aherkelman/Bachelors-Thesis-/Images/IMP/testArea.jpg

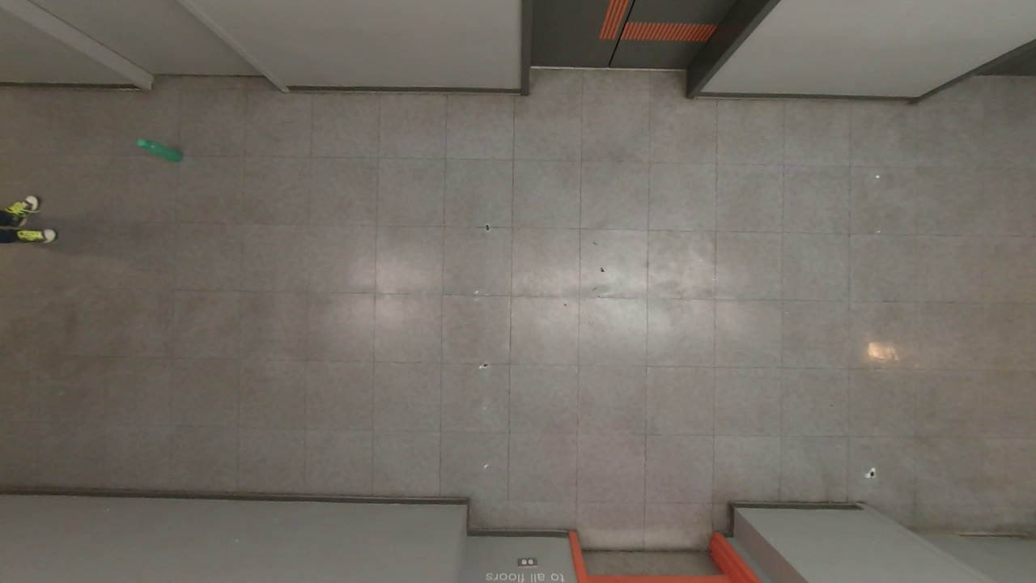
Images/IMP/testArea.jpg
