aherkelman/Bachelors-Thesis-/Images/results/1.JPG

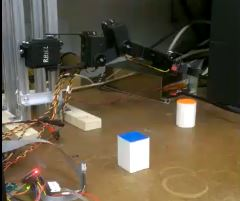
Images/results/1.JPG
