aherkelman/Bachelors-Thesis-/README.md

Bachelors-Thesis-  This project contains my bachelors thesis from 2015. See the .pdf for the printed out version.

Everything in this folder is part of the laTex generation for this thesis.
