aherkelman/Bachelors-Thesis-/Chapters/appendix.tex

\appendix

\chapter{CameraCode}\label{chap:sim_code}

\section{Object Tracking Method 1}
\lstinputlisting[basicstyle=\scriptsize,breaklines=true,language=C++]{./Code/camera1.cpp}
\section{Object Tracking Method 2}
\lstinputlisting[basicstyle=\scriptsize,breaklines=true,language=C++]{./Code/camera2.cpp}

\chapter{Path Planning and Communication}\label{chap:nao_code}

\section{Main Code}
\lstinputlisting[basicstyle=\scriptsize,breaklines=true,language=python]{./code/armTrackingMaster.py}
\section{Computer Communication}
\lstinputlisting[basicstyle=\scriptsize,breaklines=true,language=python]{./code/comms.py}
\section{Micro Controller Communication}
\lstinputlisting[basicstyle=\scriptsize,breaklines=true,language=python]{./code/communication.py}
\section{Path Planner}
\lstinputlisting[basicstyle=\scriptsize,breaklines=true,language=python]{./code/PathPlanner.py}
\section{Kinematics}
\lstinputlisting[basicstyle=\scriptsize,breaklines=true,language=python]{./code/arm.py}

\chapter{Arm Code}
\section{Main Code}
\lstinputlisting[basicstyle=\scriptsize,breaklines=true,language=C]{./code/arm_main.c}
\section{Arm Functions}
\lstinputlisting[basicstyle=\scriptsize,breaklines=true,language=C]{./code/arm.c}
