aherkelman/Bachelors-Thesis-/mainfile.pdf

# Path Planning and Object Detection for a

# Robotic Manipulator

Alaina Herkelman

May 12, 2015

Abstract

Path planning is a crucial part of controlling a robotic manipulator. To move

in an unknown environment sensors must be utilized for generating workspace

information. In this report an A start based path planning algorithm was imple-

mented for a four degree of freedom manipulator. A three dimensional camera

was used to locate the goal and obstacles within the manipulators workspace.

The results of real world implementation, modeling and the theory behind them

are discussed.

# Contents

1 Introduction | 1
2 Literature Survey | 3
3 Kinematics | 8
4 Hardware | 13
5 Image Processing | 17

i

6 Finding Ground Truth for a Mobile Platform | 26
7 Path Planning | 30
8 Modeling | 32
9 Results | 35
10 Conclusion | 39
A CameraCode | 41
B Path Planning and Communication | 49
C Arm Code | 66

ii

# List of Figures

3.1 The Mobile Manipulator | | 8
3.2 The Mobile Manipulator with Coordinate Frames | | 9
3.3 Projections for solving the inverse kinematics geometrically. . . . | 11
3.4 Workspace of the manipulator | | | 12
4.1 The manipulator | | 13
4.2 System diagram of the manipulator | | 14
4.3 Diagram of manipulator control system | | 14
4.4 Connection Circuit for Manipulator | | 15
4.5 Gripper holding cylindrical object | | 16
5.1 Arm with Camera Mounted Above | | 20
5.2 Locating a blue object in camera image. | | | 23
5.3 Shapes located in image, labeled by program | | 25
6.1 Solidworks model of GoPro mount | | 28
6.2 View of test area from GoPro | | 29
6.3 Found path of mobile platform drawn on camera image | | 29
8.1 Arm graphed onto 3D image in Matlab | | 32
8.2 Path planning simulation in matlab | | 33
8.3 Path planning model in V-REP | | 34
9.1 Manipulator moving through a planned path. | | | 38

iii

# List of Tables

3.1 D-H table | | 9
4.1 List of major components on the robotic manipulator system. . . | 15

iv

# Chapter 1

# Introduction

Robotics is becoming a more popular and useful field in the world today. Sensors

have become more accurate and practical for mapping environments allowing

robots to be used in more situations. Robotic manipulator’s are used for situa-

tions where repetitive or dangerous tasks can be replaced with robotic . This is

most commonly found in areas such as manufacturing. Combining manipulators

with machine vision allows manipulators to adapt to different environments by

visualizing the workspace.

For this project a four degree of freedom robotic manipulator was used to

grab objects within its workspace while avoiding other found obstacles. A three

dimensional camera was used to gather data about the manipulator’s workspace.

Computer vision algorithms were developed to locate known objects within the

camera’s field of view. A path planning algorithm was then set up to calculate

a path from the current arm position to a goal object and pick it up.

The algorithm used for path planning was a graph search method with an

addition of a potential fields component to help the arm avoid obstacles while

still moving towards the goal. The vision algorithms located goal objects and

obstacles by using color and basic shape detection.

The report follows the following setup: Chapter 2 discusses different methods

of path planning and object detection in images, Chapter 3 shows the results

of the kinematic models of the manipulator, Chapter 4 goes over the hardware

setup for this project, Chapter 5 states the results of developing image processing

algorithms, Chapter 6 overviews another application for computer vision in

robotics, Chapter 7 goes over the development of the path planning algorithm,

Chapters 8 and 9 discuss the results of the path planing in simulation and real

world implementation, Chapter 10 is the conclusion of the project.

# Chapter 2

# Literature Survey

Path planning is a way to generate a path for a robot to meet certain input

conditions. It is often desired to move the robot from one place to another while

going around any objects that may be in the way. The steps to do this can be

broken into two major components: finding information about the workspace

and using an algorithm to develop the path.

Path planning can be done in both static and dynamic environments. A

static environment is one that does not change. Once the workspace has been

visualized it is assumed none of the objects move. In a dynamic environment

the surroundings of the robot do change. This means that the workspace infor-

mation will change in position as the robot moves. It then becomes necessary

to both visualize and plan a path simultaneously, requiring better speed and

flexibility for both the path planner and vision methods.

## 2.1 Visualizing a Workspace

Generating data about a workspace requires some type of sensor, or sensors,

which can provide data about the robot’s surroundings. The most common

methods for this involve vision sensors and distance sensors. The overall goal is

to create some knowledge of the 3 dimensional workspace of the robot. Camera’s

are useful in locating obstacles but need some method to convert from pixels to

real world coordinates. To locate a goal in an environment using computer vision

requires some method of object recognition. There are a number of different

methods and programming libraries to help with this problem. A few common methods are described below.

### 2.1.1 Color Based

One method of finding on object in an image is based on color. The range

of pixel values for a certain color can be saved to an algorithm that searched

through an image to find pixel values within that color range. To create accurate

data from this requires some amount of filtering and correction on the image to

reduce the impact noise. The major downfall of this method is that the color

must be known to find the object and if any objects, besides the desired, are

in the same color range the results of the detection will not return the right

data. This method is therefore most useful in controlled environments where

the colors of objects in the image can be selected.

### 2.1.2 Geometery Based

An alternative to finding by color is finding by shape. The basic principle of

this is to search through the edges of an image for geometric shapes. This can

be done to find any primitive shapes in an image. A more complex shape can

be broken into a combination of geometric primitives to be located using this

method. To find a primitive shape in an image a method for edge detecting

must be used. From found edges in the image these can be searched to find the

contours matching the desired simple shape.

### 2.1.3 Feature Based

This method finds a known object in an image by comparing known ’features’

of the object to an image. An algorithm is run to find distinctive parts of an

object from a picture of it. These features are commonly lines, points, shapes

but can be anything else generated. An array of these features can be saved

and compared to features in another image. If enough of the object’s features

are found then the object is said to be found in the image. This method is

a bit more complicated but works best for finding complex objects in a more

cluttered environment.

## 2.2 Path Planning

There are many different solutions that have been developed to solve the path

planning problem. Two of the most popular are potential fields and graph

search. These methods can be broken down into more specific algorithms but

all share similar aspects.

### 2.2.1 Potential Fields

The potential fields method uses an equation to calculate the next step of the

path by repelling the solution away from obstacles while attracting it to the

goal. The equation acts as a cost function of which the global minimum is the

goal. The cost will increase the closer the obstacles and the cost will decrease

the closer to the goal. The cost functions is comprised of two parts; an attractive

field and a repulsive field.

The shape of equation that directly solves the attractive field is a conical,

which is a concave shape with the center at the goal. The problem with this

equation is that it is not continuous which causes most optimization methods

to be impossible. To fix this a quadratic equation, which increases the farther

from the goal, is added to the conic equation. The resulting equation for the

attractive field is shown in equation 2.1.

Uattract(q) =

1/2 ζdist(q, q0)

2
if dist(q, q0) ≤ d∗

d ∗ ζdist(q, q0) −

1/2 ζd²
if dist(q, q0) > d∗

(2.1)

Where ζ is a scaling factor, dist(x,y) is the distance between x and y, q is

current position, q0 is goal position, and d* is the distance between the conical

and parabolic well.

The repulsive field is set to increase quadratically based on how close the

robot is to each obstacle. For a manipulator the end effector cannot be the only

chosen point looked at in terms of collision. While the goal would only need to

look at the end effector for the attractive field, since that is the only part of the

arm desired to be at that goal. For the obstacles no point on the link is desired

to touch the obstacle. This means the whole arm, not just the end effector must

be checked for collision with the obstacle. A way to do this is by calculating

which point on the manipulator is closest to the obstacle and use that distance

to calculate the repulsive field. The result of this is shown in equation 2.2.

Urepel(q) =

1/2 ζ(

1
P (q) −

1
P0

)

2
ifP(q) ≤ P0

0 ifP(q) > P0

(2.2)

Where ζ is a tuning parameter, Pq is the distance from the closest point on the

robot to the obstacle, and P0 is the distance at which the obstacle should no

longer effect the cost.

To calculate the overall cost function the attractive and repulsive fields are

added resulting in the overall cost function. This becomes an optimization

problem and can be solved using optimization methods. The most widely used

of these for the path planning problem is the gradient descent algorithm.

The biggest problem with using potential fields is the local minimum prob-

lem. As gradient decent, or another algorithm for solving the path based on a

potential fields problem, travels through it can get stuck in a local minimum,

where no points around it are cheaper than its current yet it is not at the goal.

There are a number of methods to fix this problem, such as moving away in a

randomized direction and then continuing with the algorithm.

### 2.2.2 Graph Search

The graph search method of path planning works by finding a minimal path

between a start and end position given a set of nodes. Each of these nodes

represents a different state of the object the path planning is done for. For

example the manipulator in this project a node is a set of angles at a given

orientation of the arm. The connection cost between each of these nodes must

also be known, often calculated by distance. Nodes can either be calculated

as the search algorithm is running or generated before searching. The latter

becomes impractical for problems with a high number states and typically nodes

are calculated while searching. There are many different algorithms based on

this method some of which are described below.

## 2.3 Dijkstra’s Algorithm

Dijkstra’s algorithm is a search method which is guaranteed to find the optional

path. To do this it starts at the start node then looks at all of the neighbors. It

saves all of the neighbors of the start node and records the cost to get there. It then looks at the least cost of the saved nodes, removes it from the saved set,

and saves all of its neighbors. This is repeated until the goal is selected as the

point with the least cost.. If at any point a node is found to have a cheaper cost

when reached through a different set of neighbors the new lower cost is saved

as the cost to node. When the goal is found the cost to all nodes from the start

to end have their costs known. The optimal path can then be constructed by

moving backwards from the found end node. While this is guaranteed to find

the least cost path between start and end this algorithm also looks at a large

amount of unnecessary nodes as it looks at neighbors in all directions. This

algorithm is accurate but inefficient.

## 2.4 Greedy Algorithm

On the opposite end of the speed versus accuracy spectrum is the Greedy Algo-

rithm. It works by beginning at the start node and looking at the neighboring

nodes. It then moves to the neighbor with the least cost and throws out all

of the others. It keeps doing this until the end node is reached. This method

creates the optimal path in the optimal amount of time given a very direct path

is the optimal solution. As this is often not the case the greedy algorithm is not

a practical search algorithm.

## 2.5 A*

The A* method follows the same steps as Dijkstra’s algorithm where is saves

all of the neighbors of the node it is currently looking at. Unlike in Dijkstra’s

algorithm the cost is calculated a function of both the cost to reach the node

and an estimate of the cost to the distance. This means the cost is more for

nodes going away from the goal and less for the nodes towards the goal. This

significantly reduces the number of nodes that are looked at as when tuned

properly only likely nodes will be looked at. The A* algorithm provides a

balance between accuracy and time as it only looks at nodes it views as potential

candidates for reaching the goal quickly. If tuned correctly A* will return the

optimal path.

# Chapter 3

# Kinematics

The manipulator used was a four degree of freedom (DOF) arm with a gripper

attached as the end effector. All joints were revolute and implemented by servo

motors. A drawing of the arm is shown in Figure 3.1. To properly control the

manipulator the forward and inverse kinematics were derived.

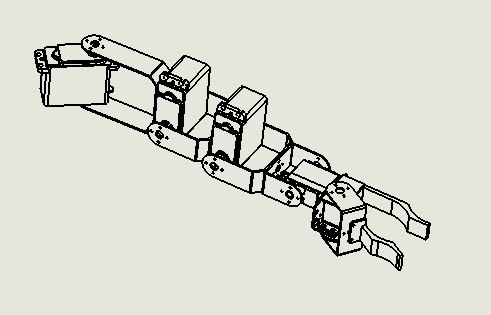
[picture p3: figure]

Figure 3.1: The Mobile Manipulator

## 3.1 Forward Kinematics

Forward kinematics is finding the position and orientation of a manipulator’s

end effector given the position of all of its joints. For this manipulator the end

effector position was calculated in terms of the angles of the first four joints of

the manipulator θ1 - θ4. The gripper was considered only as a length as it has

no effect on the arm’s overall position or orientation. An manipulator simplified

as a drawing of its joints can be seen in Figure 3.2.

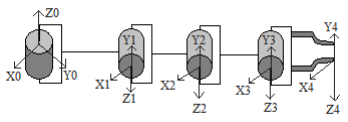
[picture p4: figure]

Figure 3.2: The Mobile Manipulator with Coordinate Frames

Joint | di | αi | ai | θi
1 | 0 | −90o | l1 | θ1∗
2 | 0 | 0 o | l2 | θ2∗
3 | 0 | o 0 | l3 | θ3∗
4 | 0 | 0 o | l4 | θ4∗

Table 3.1: D-H table

The coordinate frames of each of the joints were found using the Devavit-

Hartenberg (D-H) convention. The resulting coordinate frames and DH param-

eters are also drawn in Figure 3.2. The D-H table, which contains each of the

D-H parameters for calculating the transformation matrix of each joint is shown

in Table 1. The matrix for each joint was then calculated using the formula in

equation 3.1 where Ai
is the transformation matrix between the coordinate

frame oixiyizi and oi−1xi−1yi−1zi−1 where o0x0y0z0 is the origin coordinate

frame. The transformation matrix T
0/4, to convert from the coordinate frame of

the end effector to the coordinate frame of the origin is found by multiplying all

of the A matrices together. So T

0
4 = A1 ∗A2 ∗A3 ∗A4. The fourth column of this

matrix represents the the 3-Dimensional (3D) coordinates of the manipulator’s

end effector with respect to the origin coordinate frame. R14 is the x position

R24 is the y position and R34 is the z position where R =

r11 | r12 | r13 | r14
r21 | r22 | r23 | r24
r31 | r32 | r33 | r34
r41 | r42 | r43 | r44

This column then returns the equations for x, y, and z in terms of the angles

θ1 - θ4. As these equations are very long the matrices above were calculated for

each value and multiplied in code rather than writing out the equations.

cosθi | −sinθicosαi | sinθisinαi | αicosθi
sinθi | cosθicosαi | −cosθisinαi | αisinθi
0 | sinαi | cosαi | di
0 | 0 | 0 | 1

(3.1)

## 3.2 Inverse Kinematics

The inverse kinematics of a manipulator are a way to calculated the position of

each of the joints of a manipulator in terms of end effector position. The inverse

kinematics of this manipulator were simple enough to be calculated analytically.

The process of this is discussed below.

The last three angles of the manipulator θ2, θ3, and θ4 all lie within the

same plane as each other. This plane’s location in 3D space is determined by θ1

which only moves in the x-y plane. The projection of the arm onto the x-y plane

is shown in Figure 3.3a where xc and yc are the desired x and y coordinates of

the end effector. From this drawing it is easy to see that θ1 can be calculated

as the inverse tangent of (xc)
yc

or θ1 = Atan2(xc, yc) where Atan2 is the inverse

tangent function taking signs into consideration.

The remaining three angles can be projected into the plane formed by the

z-axis and the plane determined by θ1 in the x-y axis. This is seen in Figure

3.3b where r = p
x

2 + y

2 − l1 which is the length of the projected manipulator

on the x-y plane. Two equations can be found for zc and r using geometric

properties on the projected image. Since only two equations can be found and

there are three unknown variables the desired orientation of the end effector θc

must be specified. The resulting three equations are shown in equation 3.2.

zc = l2sinθ2 + l3sin(θ2 + θ3) + l4sinθc | (3.2a)
r = l2cosθ2 + l3cos(θ2 + θ3) + l4cosθc | (3.2b)
θc = θ2 + θ3 + θ4 | (3.2c)

These equations were solved for θ2, θ3, and θ4. The final results for the

inverse kinematics; θ1, θ2, θ3, and θ4 in terms of xc, yc, zc, andθc are shown in

equation 3.3.

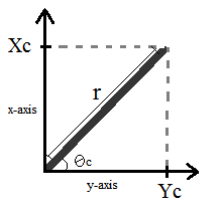
[picture p5: figure]

(a) Projection of Manipulator

onto the XY axis

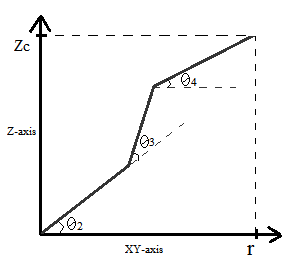
[picture p6: figure]

(b) Projection of Manipulator

onto the Z-plane Axis.

Figure 3.3: Projections for solving the inverse kinematics geometrically.

θ1 = Atan2(yc, xc)

(3.3a)

θ3 = cos⁻¹
(

(zc − l4sinθc)

2 + (r − l4cosθc)

2 − l

2
2 − l

2
3
2l2l3

)

(3.3b)

θ2 = tan⁻¹

(fraczc − l4sinθcr − l4cosθc) − tan⁻¹ (frac[l3sinθ3], [l2l3cosθ3])

(3.3c)

θ4 = θc − θ2 − θ3 r =

p
x

2
c + y

2
c − l1

(3.3d)

It also becomes helpful to have a way to calculate if the increase kinematics

is possible. If the calculation of θ3 is an imaginary number than there is no real

solution to the inverse kinematics. Inverse cos returns an imaginary number

when taking the inverse of a number greater than one. Therefore if the denom-

inator is bigger than the numerator than the resulting θ3 will be imaginary. So

if (zc − l4sin(θc))² + (r − l4cos(θc))² − l

2
2 − l

2/3) < 2l2l3 than the desired x,y,z

coordinates are outside of the workspace of the manipulator.

The physical constraints of the manipulator must also be taken into account.

Due to the way the arm is constructed the each joints has a limit of the angles

it can be set to. The are as follows; −90o ≤ θ1 ≤ 90o | , −50o ≤ θ2 ≤ 120o
,

−55o ≤ θ3 ≤ 120o

, −110o ≤ θ4 ≤ 90o
. These constraints were found by finding

the angle at which the joints cannot turn farther without colliding with another

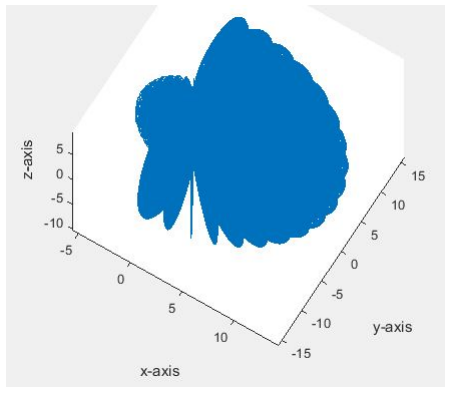
[picture p7: figure]

Figure 3.4: Workspace of the manipulator

part of the arm. A sample of the manipulator workspace taken at all possible

angles with an increment of 5o
is shown in Figure 3.4. The code for handling

the kinematics of the manipulator can be seen in Appendix B.5.

# Chapter 4

# Hardware

The setup of the manipulator was a 3D camera mounted above the manipulator

to view its workspace. A micro-controller and computer were the main methods

of control. The manipulator control system is set up as seen in the diagram

in Figure 4.2. Camera data is read in and processed by the computer, the

results are sent to the micro controller, which sends PWM signals to the servo

motors through a power and control circuit. A diagram of connections within

this system can be seen in Figure 4.3 The code to handle the communication of

the system can be found in Appendix B.

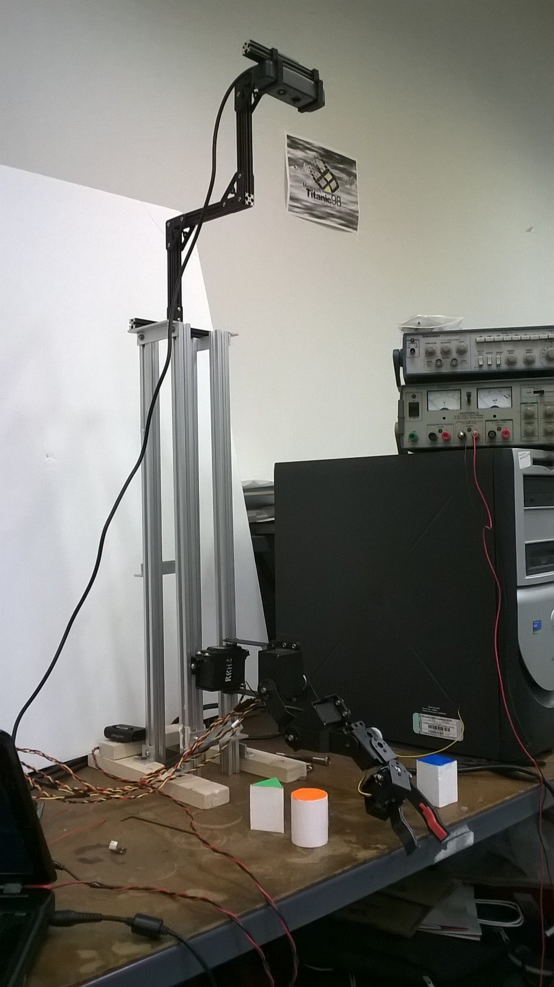
[picture p8: figure]

Figure 4.1: The manipulator.

The servos used to construct this arm had no method of feedback. The

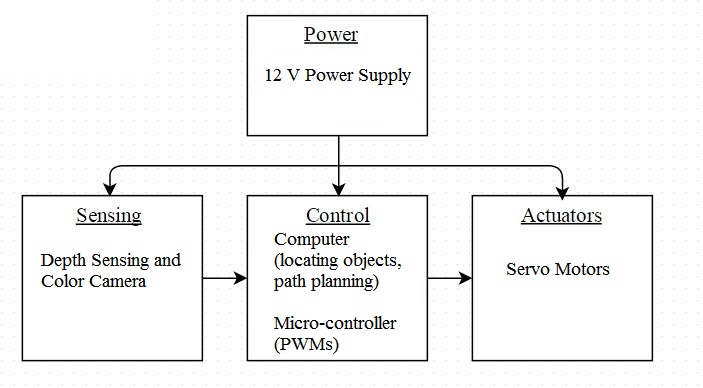
[picture p9: figure]

Figure 4.2: System diagram of the manipulator.

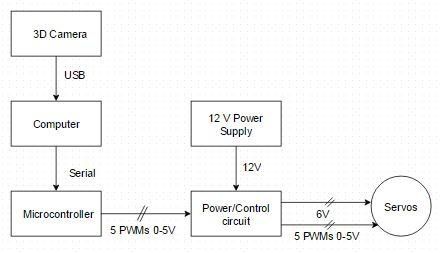
[picture p10: figure]

Figure 4.3: Diagram of manipulator control system.

connections of each servo were power, ground, and input signal. Unlike some

more expensive servos which have a connection for some or multiple types of

feedback these servos are operated as a feed forward system. This means that

commands that are given are not adjusted by any kind of error provided by a

feedback system. The code on the micro controller for controlling these servos

can be seen in Appendix C.

The camera used was a Creative Senz 3D depth sensing and color camera.

The computer code was run on Linux using bot C++ and Python. The micro

controller used was a small lab built autopilot. The processor on the autopilot

was a TM4C controller. The TM4C was used to control the servos. This code

was originally designed on an RM48 processor but switched over to make future

integration with a mobile platform robot easier. The manipulator itself is con-

structed from Hitec servos and the associated brackets. A list of all components can be found in Table 4.1.

Table 4.1: List of major components on the robotic manipulator system.

Component | Description
Baby Autopilot(BAP) | Small single processor control unit. • 80 Mhz TM4C123GH6PZ micro-controller with 32 kB internal RAM and 256 kB internal Flash • 2 UARTs • 8 PWM outputs
Camera | USB Color and Depth Sensing camera • USB 2.0 and USB 3.0 compliance • Max frame rate of 30fps • Depth range from 6 in to 3 ft.
Servos | Servo motors • Pulse Width Control 1500usec Neutral • 6V operating voltage

The power/control circuit is mostly a 6-volt regulator with connections be-

tween the servos and micro controller. The layout is shown in Figure 4.4. An

enable pin and jumper were used so that the servos only receive power when

an enable signal, GPIO of 3.3v, is sent from the micro controller. The jumper

can also be removed to stop powering the servos in the case power needed to be

shut off quickly.

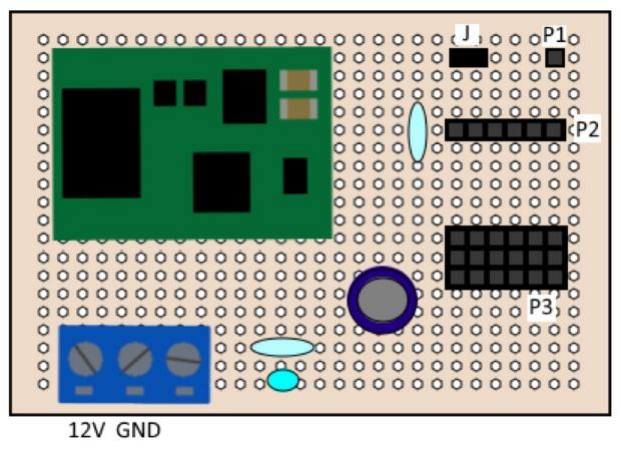
[picture p11: figure]

Figure 4.4: Connection Circuit for Manipulator.

The last major design component for the hardware was the manipulator’s

gripper. It was built from a combination of a Hitec servo, existing brackets, and

3D printed pieces. The design concept was a fixed thumb with an opening and

closing finder controlled by the servo. All parts were modeled in Solidworks and

the thumb and finger pieces printed. Rubber was glued onto the 3D printed

pieces to increase the friction when picking up objects. The assembly of the

gripper opened and closed around a cylindrical object is shown in Figure 4.5.

The object and similar objects were also 3D printed and used as the goal and

obstacles for the arm.

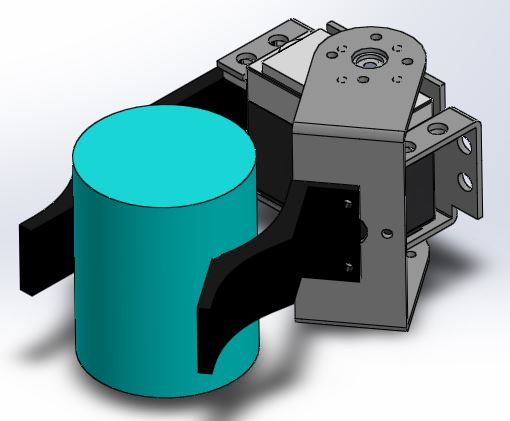
[picture p12: figure]

Figure 4.5: Gripper holding cylindrical object.

# Chapter 5

# Image Processing

To locate objects in the manipulator workspace computer vision methods were

used. The Creative Senz 3D depth sensing camera was used to gather depth and

color data of the workspace. OpenCV was then used to locate objects in the

read images. The depth data could than be used to actually calculate the xyz

position of the found image location. This was the general method for locating

objects in the manipulator’s workspace.

## 5.1 Creative Senz 3D

The Creative Senz 3D camera produces three different outputs which is sends

using USB; sound, depth data, and color images. Each of these is read in by the

computer by connecting to the corresponding data streams. To make the camera

Linux compatible the DepthSense Software Development Kit (SDK) was used.

This software was designed for use with SoftKinetics’s 3D cameras but currently

works with the Creative Senz 3D. The SDK for the Creative camera was not

used as it is a Window’s only program. Linux compatability was important for

future work to be able to put code to interface with the camera could by run

on Odroid which runs a Linux operating system.

## 5.2 Depthsense SDK

The DepthSense SDK libraries provide classes and functions for handling the

camera data as well as sample code for reading in the data. The main function for gathering data initializes the color and depth nodes than waits for new data

of each of those to be received. The nodes for color and depth can be configured

to return the desired types of data. For example the different depth data types

used in this project were the UV Map, depthMap, and VerticesFloatingPoint

and the color data was colorMap. The colorMap data stores the Red Green

Blue (RGB) values for each pixel in the color image. The depthMap and ver-

ticiesFloatingPoint stores the xyz coordinates of each depth point as calculated

in the SDK. The UVMap data is used to convert between the depth image and

color image. This is necessary because the depth image is not taken at the exact

same place on the camera as the color image and the two images are not the

same size. Therefore to find the depth at a color pixel coordinate or the color

of a point on the depth map on a way to convert between them is necessary.

The v member of the uv map refers to the row, or height, of the color image

and the v refers to the column or width of the color image. The conversion

algorithm between color pixel coordinates to the uv coordinate is shown in

algorithm 1.

Algorithm 1 Use UV map to convert from depth location to pixel coordinates.

1. Get UV map from DepthSenseSDK.
2. colorImageRow = V member of UV * height of color image.
3. colorImageColumn = U member of UV * width of color image.

Reading in the color image and depth image as well as converting between

locations in the two is all that is necessary from the Depthsense SDK software.

This code makes up the main part of the camera code. The main function calls

the functions necessary to set up the nodes and then waits for data. Functions

exist called OnNewDepthSample and OnNewColorSample which run every time

new data of this type is received. It is in these functions where data was read

into variables to be used for further analysis.

## 5.3 Finding Depth Data at a Desired Location

Once an object is located in the color image the xyz coordinates must be found.

To do this the depth map is searched through and using the uv mapping tech-nique discussed above the row and column of the color image is found for each

depth point. If the row and column matches the xy position of the found

object than that depth position in xyz coordinates, found by using the verti-

ciesFloatingPoint depth data, is stored as the real world position of the image

coordinates.

For more consistent readings of depth an average of the points around the

found object was used rather than just the center point. This is because there

are some holes in the depth data, where it reads a default 0,0,0 coordinate. This

happens most often when an object starts approaching the lower limit of range

on the camera. The average was a way to avoid no data being returned in these

situations. The area used was ± a third of the found objects bounding circle

radius. This gives enough points to create a safe average while guaranteeing the

area is always within the desired object regardless of size.

Algorithm 2 Find world coordinates of a pixel coordinate

1. x,y = found pixel position in color image
2. radius = radius of objects bounding circle
3. boundaries = x,y±radius/3
4. for all depth data
5. use uv map to find corresponding pixel location
6. if in boundaries save VerticesFloatingPoint to averaging point
7. take average of found XYZ coordinates
8. filter found coordinates

The found xyz position was also put through a low pass filter as the coordi-

nates had a fair amount of noise. The filter used was a 3rd order Butterworth

Filter whose equation is shown in equation 5.1. The derivation of this formula

can be seen in Appendix 2. The algorithm for the camera coordinate to world

coordinate position is shown in algorithm 3.

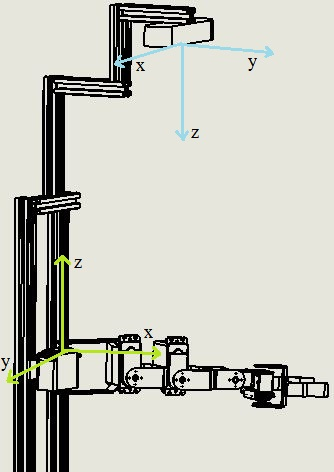
[picture p13: figure]

Figure 5.1: Arm with Camera Mounted Above.

y =

w

2
cx − 2w

2
cxp + w

2
cxpp − yp(2w

2
c −

8
T ² ) − 4 − ypp(w

2
c −

2

√
2wc
T +

4
T ² )

4
T ² +

2

√
2wc
T + w²
c
(5.1)

Where x is the current value, xp is the previous value, xpp is the previous

previous value, yp is the previous filtered value, and ypp is the previous previous

filtered value.

The final step in getting a usable xyz position is to convert from the camera

coordinate frame to the base frame of the manipulator. The camera’s coordinate

frame is at the center point between the depth and color camera’s and the

manipulators coordinate frame is at the first joint of the manipulator. These

frames are shown in Figure 6.1. The conversion between these frames is found

by the equations in 5.2.

xarm = ycam + a | (5.2a)
yarm = xcam | (5.2b)
xarm = zcam − b | (5.2c)

Where distance a is the distance between xarm and ycam measured along the

zarm axis and the distance b is the difference between zarm and zcam measured

along the xarm axis.

### 5.3.1 Point Cloud Library

The Point Cloud Library (PCL) is a library used for interpreting and using

point clouds. Point clouds are a set of points in 3D space. These can refer to

a pure depth image or also contain color information. PCL has a number of

functions and examples for object recognition and tracking. It was possible to

import the depth data from the camera into point cloud form and view using

PCL’s viewing functions. The PCL functions for object recognition did not turn

out to be reliable for this project. The alternative looked at was Open Source

Computer Vision (OpenCV) which more reliably found objects with the camera

data.

### 5.3.2 Open CV

OpenCV is another library with image processing functions which works across

different computer languages and operating systems. The DepthSense SDK was

written in C++ so the C++ version of OpenCV functions were utilized in this

project. OpenCV has a number of different functions such as color detection,

finding contours, shape fitting, and image filtering. Many of these functions

were used for object detection in this project.

### 5.3.3 First Version

The first version of object detection was written based on color. First the color

image was save as a Mat, or matrix type, which is how OpenCV saves images.

The image was then converted from an RGB to HSV (Hue, Saturation, and

Value). HSV has an advantage over RGB for color detection as it is easy to

cover a range of saturations for a particular color, or hue, by only changing the

saturation value rather than recalculating the RGB values for a slight change in

saturation. The HSV range of the color was saved and compared to the pixels

in the color image. A matrix of the same size was saved with a one if the pixel

was in range and a zero if it was not. The result is a binary image, which is

viewed as a black and white image, white for a value of one and black for a

value of zero. This image was then put through filtering functions to remove

holes and small objects caused by noise in the color image and the result is the

object found in the image of that color.

The contours of the binary image were then found. Contours are the enclos-

ing shapes found around the edges of an image. Assuming only one object of

the desired color is in the image all found contours were merged. The OpenCV

function to find the minimum enclosing circle around a contour was used to

return the center point and radius of the found object.

The code for this object location program is shown in Appendix C. While

this code worked consistently it did have limitations. As stated above it relies on

the assumption that only one object of the desired color is present in the camera

image. If there is more than one the center point returned will be somewhere

in between with a radius big enough to contain all objects of that color. The

program also find the minimum enclosing circle of the object regardless of its

shape. This means there is no way to determine the difference between a circle,

square, or any other shape in this code. It was therefore necessary to create a

more well rounded algorithm for object detection.

An example of this can be seen in the images of Figure5.2. To track an object

of the color blue the HSV values were found to be: H = 100 - 130, S = 100-255,

V = 49-255. The original image is shown in Figure 5.2a. The thresholded image

before filtering, after finding blue, is shown in Figure 5.2b and after filtering in

Figure 5.2c. The found contours of the image are shown in Figure 5.2d and

finally the minimum enclosing circle drawn onto the image along with the found

center point is shown in Figure 5.2e. This program ran fast enough to track an

object in real time and calculate 3D coordinates. Viewing the results on screen

has no noticeable delay.

### 5.3.4 Second Version

To fix the limitations seen from the first version of the code a new version was

written based on basic shape detection. The goal is to find basic shapes, such

as circles, triangles, and squares from a color image.

Shape detection started out similar to the color tracking code by creating

a binary image for selected colors. For testing purposes the color selection was

set to select all but the background colors. Using a binary image is much more

reliable for the contour and shape detection functions in OpenCV which is why

there is still a color based part to this code. This image was left unfiltered as

the filtering process used in the color method rounds out the shapes too much

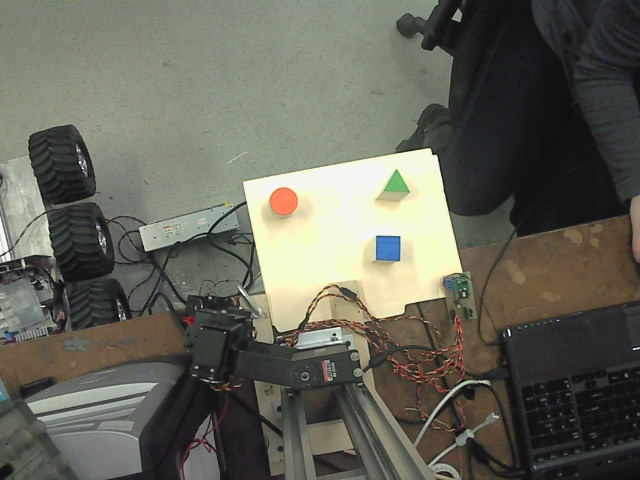
[picture p14: figure]

(a) Original color image.

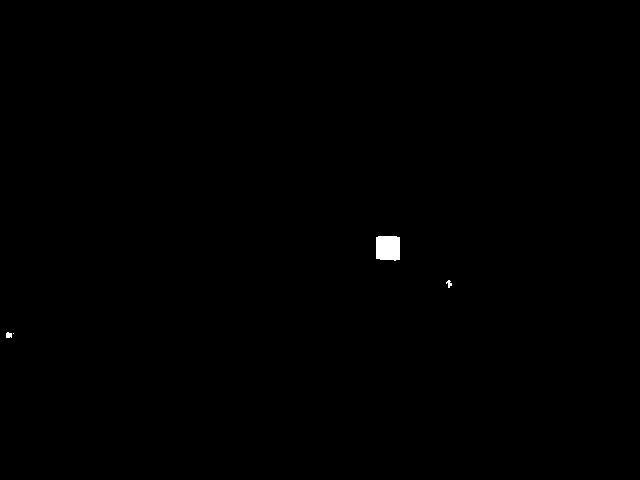
[picture p15: figure]

(b) Binary image of found blue

color before filtering.

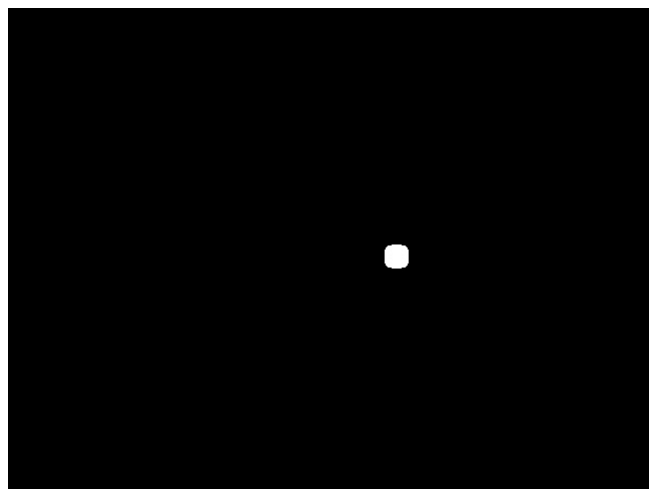
[picture p16: figure]

(c) Binary image of found blue

color after filtering..

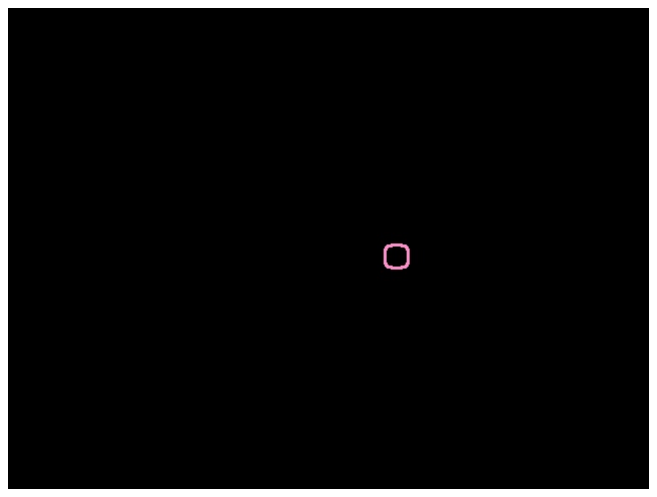
[picture p17: figure]

(d) Found contours of blue

object.

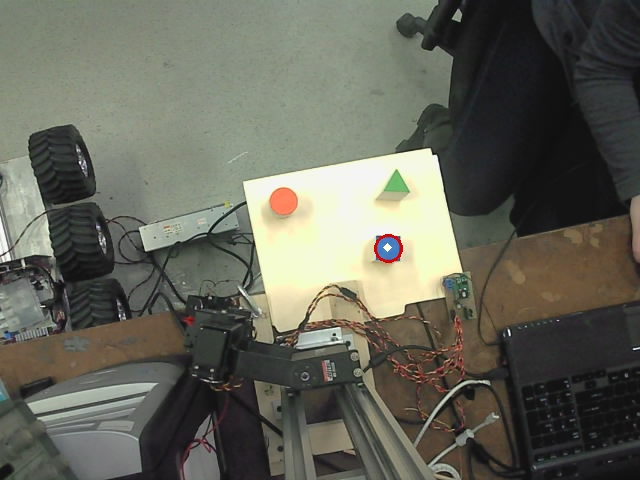
[picture p18: figure]

(e) Minimum enclosing circle

drawn around found object in

original image.

Figure 5.2: Locating a blue object in camera image.

for any kind of detection to work. Since the objects used in this project are so

small in camera frame even a little bit of smoothing cuts off the corners needed

for shape detection. Therefore the unfiltered image was put in the find contours

function.

To then ignore all the smaller shapes only the convex contours with a larger

area were looked at. Both area and convexity of a contour can be checked with

OpenCV functions. For each contour meeting this criteria the approximate

polygon function was used which returns a set of vertices’s for the contour.

To detect the shapes the number of vertices’s was used. The three shapes

recognized for this program were triangle, square, and circle. The shapes were

determined by the appropriate number of vertices’s, for a square four and for

a triangle three. The circle was marked as found for any contours with five or

more vertices’s. Normally this would be assumed to be a larger number but

since the objects were small the approximate polygon function often found the

circle to have only five vertices’s. To restrict the conditions of shape further

the angles between the vertices’s can also be calculated. So for a square all the

angles should be approximately 90 degrees, for a triangle the angles should sum

to around 180 degrees, and so on. For this situation the shapes were located

more easily without adding these extra conditions. There was too much noise

present in the image and adding this extra angle constraint resulted in no shapes

being found most of the time. Since just the vertices’s condition worked much

better this was the only criteria used for shape matching.

Once found the program drew a line between all vertices’s on the image and

labeled it with the shape it was determined to be. An image of this working is

shown in Figure 5.3.

This method often read incorrect shapes without a clean workspace. It

always found the objects but did not estimate them to have the correct number

of vertices. When putting the objects onto a white background enough noise

was eliminated to make this method much more reliable.

To find the coordinates of the center of the shape a geometric method can

be used based on the shape found. For a square the center is found as halfway

from the distance of two adjacent sides. A triangle center is found as halfway

between the center of one side and the opposite point. The simplest method for

finding the center of the circle was to use the minimum bounding circle function

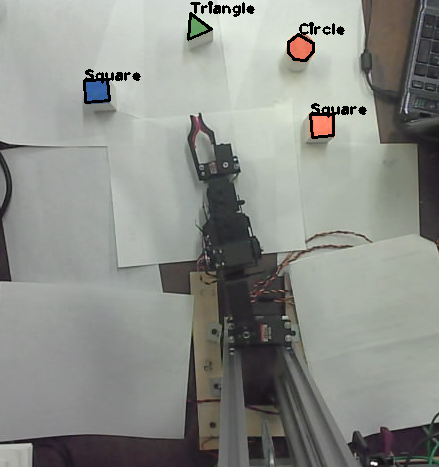
[picture p19: figure]

Figure 5.3: Shapes located in image, labeled by program.

on the circle contour.

To locate all of the objects in the workspace for this experiment a combi-

nation of color and shape locating was used. Given an object for input first

the color of the object is found and a binary image created for just that color.

That image is then searched for the corresponding shape of the obstacle and

the center point is returned. With this modification more than one object of

the same color can be present in the image and an accurate result produced.

While this code was tested with the same workspace as used for the manip-

ulator, the first version of the code was used for this project. The first version

had less room for error and was simpler to implement. This version does provide

a future more robust alternative. The code for both versions of the image code

can be found in Appendix A.

# Chapter 6

# Finding Ground Truth for a

# Mobile Platform

The image code written in Open CV was not just for use with object detection

for the manipulator. The first Open CV code for color detection was used in a

program to calculate the ground truth, or path traveled, by a mobile platform

from an overhead video. The first object recognition code works for this purpose

because the environment for these tests was controlled, meaning the robot was

the only object of a color in the video. The ground truth is important to have

so that it can be compared to results of path reconstruction based on sensors

on the robot.

For this situation a red rectangle was placed on top of the platform and

video taken from above the test area using a GoPro camera. Loading the video

file into the open CV program after. The video was analyzed one frame at a

time to locate the robot and record its center position. The colored rectangle

was positioned on the robot in such a way that the center of the rectangle was

also the center of the robot.

## 6.1 First Solution

Unlike with the color tracking using the depth camera the pixel coordinate of

the desired location is not enough to get a estimate of the real world xyz position

of the point as there is no depth data. It was therefore necessary to find another way to accurately measure the world coordinates of the robots center. The first

method tried for this was using a least squares method to derive a linear equation

to convert between pixel and world coordinates. The world coordinates were

only calculated as an xy point as the robot traveled across a smooth surface and

the z value was constant. A set of about 20 points were taken from the image

at points where the world coordinates were known. Since the floor of the test

area had tiles of a known size so the corners were used as the known points.

The conversion was setup as y = Ax+B where y is the vector of real world

xy coordinates, x is the pixel uv values, and A and B were matrices found using

least squares. The matrix A˜ which equals [A|B] was solved by Y X(XXT
)

−1

where XXT
is an invertible matrix and Y and X are full of known conversion

points. These calculations were done to find A and B in Matlab and then put

into the path finding code to convert to world coordinates.

This method had a number of problems; mainly inaccuracy and manual

work. The linear system calculated did not provide a good estimate for convert-

ing to world coordinates. At times the result was eight inches from the actual

xy coordinate. The desired accuracy range was to be with two inches of the

actual value. Each time a new data was acquired the A and B matrices had

to be recalculated. This is because the camera’s position changes enough each

time it was mounted above the test area to make the old matrices unusable.

This meant that for each new run points would need to be found by hand to

resolve for the A B matrices before being able to run the tracking program.

## 6.2 Second Solution

To address these issues the first step was to mount the GoPro in such a way

that its positioning in the test area was always the same, or at very least close

enough to the same to produce a manageable error. The mount that comes with

the GoPro has multiple bendable joints so even if mounted at the same location

the camera is not likely to be in the same orientation. A more stationary mount

for the GoPro was designed in Solidworks. The design was to have a case to

hold the GoPro which was attached to a clip that fit around the overhead light

in the test area. The point at which the clip attached to the light was marked

on the light and allowed the camera to be mounted at the same height and angle for all test runs in the environment. Figure 6.1 shows the Solidworks model for

this mount which was then 3D printed and used to hold the camera.

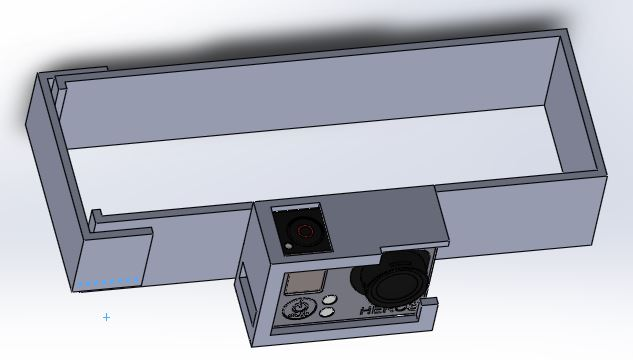
[picture p20: figure]

Figure 6.1: Solidworks model of GoPro mount.

With the camera in a fixed location a more accurate way to convert the pixel

coordinates to world coordinates was developed. To account for the changes in

position caused by the height of the mobile platform about thirty-five data

points were gathered to convert the center of an objects pixel coordinates to

the real world coordinates. The object used for this was the same height was

the robot to create the same offset. This offset can be seen in Figure 6.2a. The

bottle was placed at the corner of four tiles yet since the camera is not directly

above it the object’s center does not appear to be at the corner. The first version

of the code did not account for this distortion and added to its inaccuracy.

An equation was made to generate the x and y world coordinates, The x-

coordinate equation was linear and only dependent on the corresponding u pixel

value. The y coordinate equation was a function of both the u and v pixel co-

ordinates. This is because the lines found for the tiles were not perpendicular

as the horizontal lines sloped slightly upwards making the y calculations a func-

tion of both x and y. A lookup table was generated for each tile corder in the

test area based on these equations. Figure 6.2b shows the generated points,

in black, compared to those hand gathered, in blue. The lookup table could

then be implemented in the main path locating program to convert to world

coordinates.

The results of this program were more accurate, within about 2 inches of the

actual location, which was the desired accuracy. It was also no longer necessary

to recalculate formulas for each new test in the environment. An example of

the generated path is shown in Figure 6.3. There is some jitters in the found


(a) Demonstration of 3D object offset.

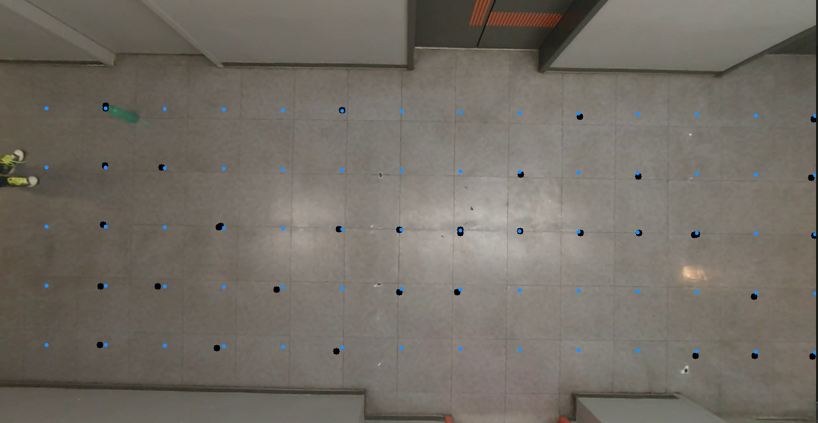
[picture p21: figure]

(b) Generated points versus manually found

points.

Figure 6.2: View of test area from GoPro.

path due to the color detection not creating the ideal data. Low pass filtering

does improve the path making it smother, but there is still some inaccuracy.

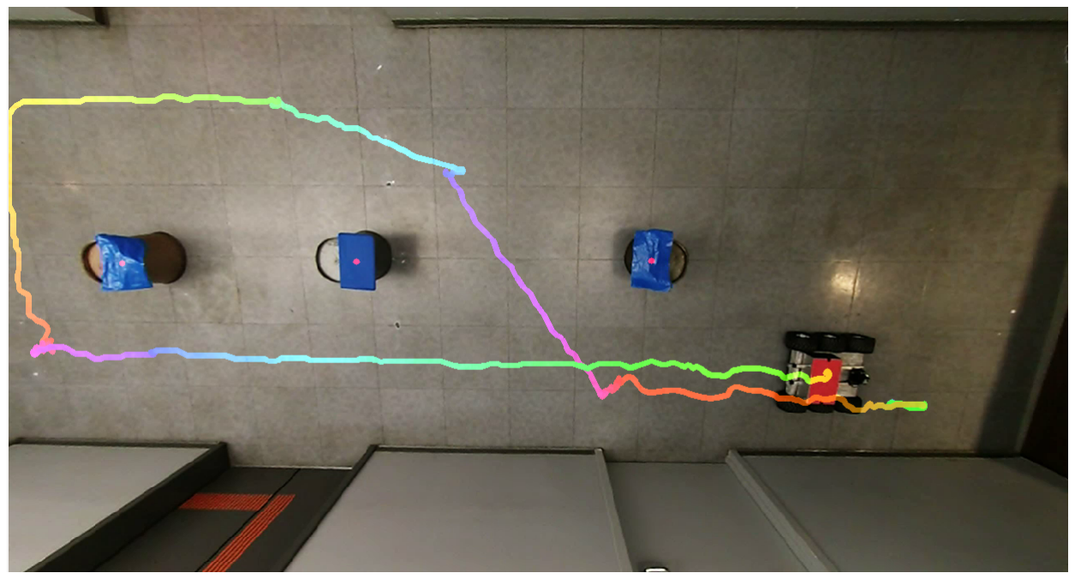
[picture p22: figure]

Figure 6.3: Found path of mobile platform drawn on camera image.

# Chapter 7

# Path Planning

The method selected for path planning was a graph search algorithm using

A star (A*). The algorithm was first written and tested in Matlab and the

rewritten to ne implemented on the real manipulator in python.

## 7.1 Path Planning for the Manipulator

The first step of the path planning code was to find a way to discretize the

workspace of the manipulator. The angle apace, θ1, θ2, θ3, and θ4 was used,

rather than the alternative of using the x,y,z,θc position coordinates. This choice

was made so that each part of the found path would be guaranteed to be in the

workspace of the manipulator. By changing the step between the manipulators

rather than the position the trajectory is guaranteed to be smooth since each

angle will only be changed at most by a step size. Using the xyz position can

results in large jumps between the angles to reach a small change in end effector

position because of major configuration changes between them. To calculate

the neighbors of the current node the angles are by a maximum of a set step

size.

The obstacles were entered into the path planning algorithm by keeping track

of the xyz position of the obstacle. No further definition was necessary. Rather

than calculate the arm nodes which would cause a collision with the obstacle the

position of it was used as a parameter of the total cost function for each node.

The closer the position of the end effector to the obstacle the higher the cost to

go to that position. This acts as a potential field pushing the arm away from the obstacles. With proper tuning the arm is able to avoid the obstacles while

traveling to the goal. The obstacle cost was taken as 1/distance between the

end effector position and the obstacle center. This cost was found and summed

for each obstacle, then multiplied by a tuning parameter and added to the total

cost.

The A* algorithm was implemented to calculate the path of the arm. The

total cost of each node was calculated by A* distance between start node and

current node + B*distance between current node and goal node + C* 1/sum

of distance between current node and each obstacle where A, B, and C are

wights adjusted for best results. The algorithm for this is shown in Algorithm

3. It calculates the optimal path between a start position and end position

while avoiding all inputted obstacles. Since the goal of this program is to pick

up an object the path had to be separated into two different pieces. The first

considered the goal object as an obstacle to avoid colliding with it before picking

it up and traveling to a point a about two inches away from the goal. At

this point the gripper was opened and a new path calculated from the current

position to the goal where the gripper was then closed and the object picked

up. The code for the path planner is found in Appendix B.

Algorithm 3 Find world coordinates of a pixel coordinate

1. Add start position to the nodes to be looked at.
2. While still nodes to look at
3. Set node with lowest total cost as current node
4. Mark node as having been visited, save position this node came from.
5. If this node is within a small distance of goal position exit loop.
6. Calculate all neighbors of current nodes and their costs.
7. If node is within constraints and has not been visited already save to nodes

to be looked at array.

8. Create path by using came from and visited arrays

# Chapter 8

# Modeling

All models of the robotic manipulator were Matlab based. The first models

were made simply as tests for the kinematics calculations. Given a set of angles

the manipulator was drawn as a line between each of the joint positions. Each

of these positions is calculated using the A matrices calculated for the joints as

described in the Kinematics’ section. So the first joint is calculated by the last

column of A. Location of the second joint is located at A1A2’s fourth column

and so on. The origin, (0,0,0) is selected as the origin of the manipulator, the

start of the first joint. The result of this is shown in Figure 8.1. With this

setup it was possible to test the actions of the manipulator based on different

functions.

The inverse kinematics was tested using this model before testing on the real

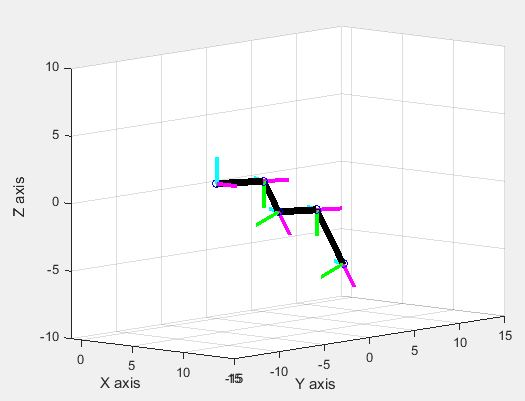
[picture p23: figure]

Figure 8.1: Arm graphed onto 3D image in Matlab.

manipulator. The inverse kinematics equations along with the joint limits were

programmed into a matlab function. The program could draw the resulting

arm configuration for any desired end effector position in the workspace. For

cases was not solvable the arm simply did not move, this was determined using

the inverse kinematics feasibility test described in Chapter 3. The physical

constraints were also programmed into the code to stop the arm for traveling

outside of the physical angle limitations. Testing this code confirmed that the

workspace of the manipulator is convex. This means that from one existing

point in the workspace to other point in the workspace then the line between

them is also in the workspace. This fact was use to create a trajectory from a

starting position to a desired end position by calculating the linear path between

them.

The next model was made to test the path planning code. In matlab ob-

stacles were drawn on the 3D graph with the centers at the inputted obstacle

value. The path planning algorithm then computed the path for the manip-

ulator which was drawn through each configuration in the path. This model

showed the algorithm to be able to consistently make it to the desired obstacle

location with a smooth trajectory. The matlab simulation did not include any

modeling of the gripper simply showing the path to the obstacle. An image of

this simulation is shown in Figure 8.2.

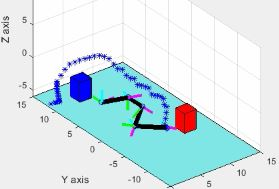
[picture p24: figure]

Figure 8.2: Path planning simulation in matlab.

A more realistic model of the manipulator was created in the Virtual Robo

Experimentation Platform (V-REP). This software includes physics engines

which could more accurately simulated the manipulator at he goal objects reac-

tions. First the servo and brackets 3D models were downloaded and the arm was

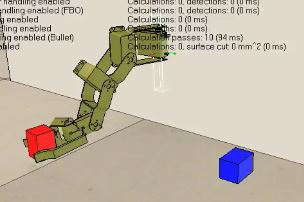
[picture p25: figure]

Figure 8.3: Path planning model in V-REP.

assembled in Solidworks to create an accurate model of the manipulator. The

3D model was imported into V-REP and each servo set as a joint. Obstacles

were created a similar size, shape, and weight as the real obstacles 3D printed

for this project. The same matlab code was used to control the joint angles in

V-REP. The simulation was then run and used to pick up objects.

The V-REP simulation was not as reliable as the matlab simulation and a few

code changes needed to be made to avoid the open gripper hitting the obstacles.

There were also some problems with the objects flying out of the gripper. This

seemed to be a result of the physics engine and after a few adjustments to the

object materials the simulation successfully picked up the object. An image of

this simulation is shown in Figure 8.3. The results of this simulation made it

seem as though the path planning algorithm was likely to work with the real

manipulator but would likely need some tuning to successfully grab objects.

# Chapter 9

# Results

Once all parts of this project were developed individually testing began on the

physical manipulator. The main code for this project was written in python and

used to call the image program to return the world coordinates of each known

obstacle in the workspace. The program then calculated a path to the desired

object while avoiding the others using the developed path planning code. The

path was then sent over serial to the micro-controller which commanded the

servos of the arm to the desired locations.

The obstacles used to test the path planning were an orange cylinder, a blue

square prism, and a green triangular prism. These objects can be seen in the

figures of the image processing section.

Implementing this code made it easier to test many different object locations

than it was with the modeled versions of the arm’s path planning. There were

a limited number of locations where obstacles could be placed that remained in

the workspace of the manipulator. It was not possible to simply place an object

anywhere near the manipulator and have it plan a path to it as some of the

locations were not possible for it to reach.

For the obstacles within the reach of the arm’s kinematics it could only

pick up a few based on the two part path developed in the models. The arm

would only successfully grab the obstacle when two conditions were met. The

first was that the path’s first approach was ended in an orientation pointing at

the obstacle, rather than being at the side. The second condition was that the

second part of the path, to actually do the grabbing did not cause the arm to hit

the obstacle before grabbing. This problem is caused by the fact that the goal location cannot be both an obstacle and goal for the whole of path planning or

the manipulator will never reach it.

The first approach to fix this problem was to add a factor into the cost

function for if the arm was pointing at the goal. The hope was that the arm

would then calculated a path in which it was facing the goal and stop it from

hitting the obstacle during the second part of the path planning. The issue

with adding the orientation cost is that there is not enough flexibility in the

manipulator workspace to get to a location and have the desired orientation.

The result of adding this parameter is with a low tuning value that the arm

ignores this orientation and simply takes longer to solve for the path it would

have taken before, or with a higher tuning value cannot find a path within a

reasonable amount of processing time. If the path calculations are not over after

a minute there it does not seem to find a solution. There was no tuning value

that could get the orientation parameter to improve the path planning.

The next approach was to set the end position of the first part of the path to

a different location depending on the angle of the first joint. The goal is to place

the arm at a position in which it is directly in front of the desired object. For

example with an object directly to the front of the manipulator, at θ1 = around

0

o
the best method was to send the manipulator to the coordinates xc −2, yc, zc

where xc, yc, zc are the goal coordinates in inches. For θ1 values around −90o

the formula was found to work best as xc, yc − 2, zc. For those in between a

point two inches in from the x and y were used. For the negative angles the

signs of the y were flipped.

For the path planning algorithm to end it was required to find a distance

where the arm was considered close enough to the point to stop the path plan-

ning. Since the angles were changed by a step size of three the arm would never

perfectly reach the location. This was set to be within half an inch of the desired

position. This means that there is some inaccuracy in the location of the end

effector to the desired position. There is also some inaccuracy when calculated

the position of the xyz coordinates. This accuracy is usually within a square

inch of the actual location. Between these two there can be an error in the end

effector location to a radius of one and a half square inches of the actual object

center. Usually there is less error than this and the gripper is wide enough to

grab the object for small amounts of error.

The biggest issue of this system was the lack of feedback. The combination of

error from the servos, camera location, and path planning results in a combined

error of over an inch. This means that the manipulator often got close to the

desired goal but not quite at the right position. The problem also arose of the

error resulting in collisions with the arm and the objects. With feedback it would

become much more possible to control this error resulting in a more reliable path

planner. Having the gripper open as wide as possible while planning a path did

help the reliability of actually grabbing the goal object, but also increased the

chance of hitting other obstacles along the way.

Overall after some adjustments to the code this program was able to grab

objects, while avoiding obstacles, for most locations in the workspace. With the

limited workspace there is not always a path to find which can successfully grab

the object without hitting it away. So while the path planner can find a smooth

path to the object it was much harder to keep the arm in an orientation where

it could actually pick up the object. The inaccuracy of the system was also a

big contribution in the unreliable grasping.

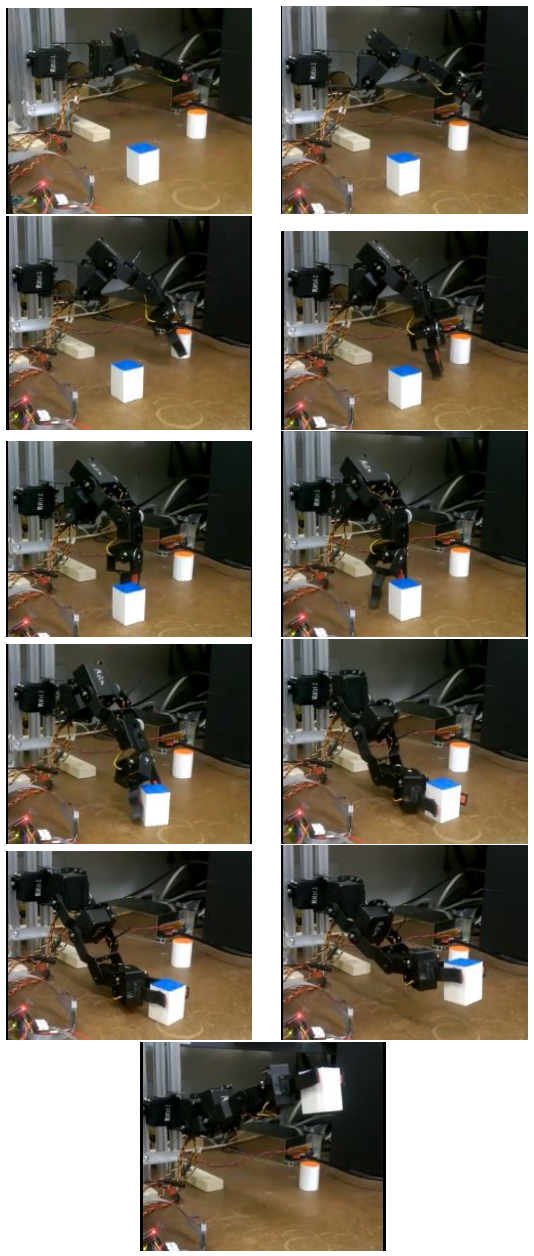
[picture p26: figure]

Figure 9.1: Manipulator moving through a planned path.

# Chapter 10

# Conclusion

Using robotic manipulators to pick up objects requires methods of path planning

and workspace visualization. The more degrees of freedom a manipulator has

the simpler the design of a path planning algorithm is but the more robust the

result becomes. As seen by the results of this project this manipulator with for

DOF has a fairly limited workspace, which becomes much more so if orientation

is desired and not just an xyz position on space. While 4 DOF is plenty to move

this manipulator to a location it is not enough to be able to grab objects well

since more orientation is needed.

If grabbing objects is desired for a manipulator with a small degrees of

freedom, such as in this project, it becomes necessary to limit the locations

where objects can be placed to be picked up. Rather than placing the object

to any place in the workspace it must be put somewhere the correct orientation

can be achieved. While this limits more robust applications this sort of design

could be used in a manufacturing situation where objects can be placed at more

exact locations that would work for the arm’s configuration. For use in a more

broad setting with less controlled object locations a manipulator with a higher

degree of freedoms would become necessary.

Even with a more maneuverable configuration the lack of feedback in the

system would still cause a reliability issue. With so much error coming from the

servos and camera the path planner can find a path that works appropriately

but does not work successfully. To develop a reliable path planner feedback is

crucial.

This project showed 3D cameras as an accurate way to visualize a workspace.

Without some form of stereo camera or a lengthy calibration process it is difficult

to obtain 3D data about a color image. The depth sensing camera is a powerful

tool to overcome the difficulty of collecting 3D data. Since depth data can be

directly mapped to a color image it is possible to get 3D world coordinates for

all points within a color image. This method is also fairly accurate to within

about half an inch in every direction making this method of gathering workspace

data very practical.

Computer vision and path planning can be used together to survey and move

a manipulator through an environment. While the path planning and data

gathering sections can be accurate the biggest challenge becomes physically

grabbing the object. Getting to the location is nor the biggest issue, that

becomes placing the manipulator in such a position accurately enough to have

a gripper close around it without any part of the gripper hitting the object too

far away. With more precise servos and more degrees of freedom this task could

certainly be accomplished.

# Appendix A

# CameraCode

## A.1 Object Tracking Method 1

void rgbImage ( cv : : Mat im gO r i g i n a l , in t ∗ xpos , in t ∗ ypos , in t ∗ r a d i )

{

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

cv : : P o i n t 2 f c e n t e r ;

f l o a t r a d i u s = 0 ;

c e n t e r . x = 0 ;

c e n t e r . y = 0 ;

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

// low was 100 i f t h a t needs t o change back

in t iLowH , iH ighH , iLowS , iH ighS , iLowV , iH ighV ;

i f ( o b j e c t [ 0 ] == 4 9 )

{

iLowH = 1 0 0 ;

iH ighH = 1 3 0 ;

iLowS = 1 0 0 ;

iH ighS = 2 5 5 ;

iLowV = 4 9 ;

iH ighV = 2 5 5 ;

}

e l s e i f ( o b j e c t [ 0 ] == 5 0 )

{

iLowH = 0 ;

iH ighH = 1 0 ;

iLowS = 1 0 0 ;

iH ighS = 2 5 5 ;

iLowV = 4 9 ;

iH ighV = 2 5 5 ;

}

e l s e i f ( o b j e c t [0 ]==51)

{

iLowH = 5 0 ;

iH ighH = 9 0 ;

iLowS = 5 0 ;

iH ighS = 2 5 5 ;

iLowV = 1 0 0 ;

iH ighV = 2 5 5 ;

}

e l s e

{

iLowH = 8 0 ;

iH ighH = 1 7 9 ;

iLowS = 0 ;

iH ighS = 2 5 5 ;

iLowV = 0 ;

iH ighV = 2 5 5 ;

}

;

cv : : Mat imgHSV ;

cv : : Mat imgL in es = cv : : Mat : : z e r o s ( im gO r i g i n a l . s i z e ( ) , CV 8UC3 ) ;

// Convert t h e cap tu r ed frame from BGR t o HSV

c v tC o l o r ( im gO r i g i n a l , imgHSV , cv : : COLOR BGR2HSV) ;

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

cv : : Mat imgThr esho ld ed = cv : : Mat : : z e r o s ( im gO r i g i n a l . s i z e ( ) , CV 8UC3

) ;

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

CV 8UC3 ) ;

cv : : Mat b a l l ;

// Finds p i x e l v a l u e s in t h e s e t HSV range ( red ) .

inRange ( imgHSV , cv : : S c a l a r ( iLowH , iLowS , iLowV ) , cv : : S c a l a r ( iH ighH ,

iH ighS , iH ighV ) , imgThr esho ld ed ) ;

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

MORPH ELLIPSE , cv : : S i z e ( 1 5 , 1 5 ) ) ) ;

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

MORPH ELLIPSE , cv : : S i z e ( 1 5 , 1 5 ) ) ) ;

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

MORPH ELLIPSE , cv : : S i z e ( 5 , 5 ) ) ) ;

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

MORPH ELLIPSE , cv : : S i z e ( 5 , 5 ) ) ) ;

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

cv : : Moments oMoments = cv : : moments ( imgThr esho ld ed ) ;

im gO r i g i n a l . copyTo ( b a l l , imgThr esho ld ed ) ;

double dM01 = oMoments . m01 ;

double dM10 = oMoments . m10 ;

double dArea = oMoments . m00 ;

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

i f ( dArea > 1 0 0 0 0 )

{

// Prepare t h e image f o r f indCon tou rs

cv : : c v tC o l o r ( b a l l , b a l l , CV BGR2GRAY) ;

cv : : t h r e s h o l d ( b a l l , b a l l , 0 , 2 5 5 , CV THRESH BINARY) ;

//Find t h e con tou rs . Use t h e contourOutput Mat so t h e o r i g i n a l

image doesn ’ t g e t o v e r w r i t t e n

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

cv : : Mat contourOutput = b a l l . c l o n e ( ) ;

cv : : f i n dC o n t o u r s ( contourOutput , c o n t o u r s , CV RETR LIST ,

CV CHAIN APPROX NONE ) ;

cv : : f i n dC o n t o u r s ( contourOutput , c o n t o u r s , CV RETR EXTERNAL ,

CV CHAIN APPROX NONE ) ;

//Draw t h e con tou rs

cv : : Mat contour Imag e ( b a l l . s i z e ( ) , CV 8UC3 , cv : : S c a l a r ( 0 , 0 , 0 ) ) ;

cv : : S c a l a r c o l o r s [ 3 ] ;

c o l o r s [ 0 ] = cv : : S c a l a r ( 2 5 5 , 0 , 0 ) ;

c o l o r s [ 1 ] = cv : : S c a l a r ( 0 , 2 5 5 , 0 ) ;

c o l o r s [ 2 ] = cv : : S c a l a r ( 0 , 0 , 2 5 5 ) ;

cv : :RNG rng ( 1 2 3 4 5 ) ;

// approx imate con tou rs

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

( ) ) ;

fo r ( in t i = 0 ; i < c o n t o u r s . s i z e ( ) ; i++ )

{

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

) ;

}

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

fo r ( in t i = 0 ; i < c o n t o u r s p o l . s i z e ( ) ; i++)

{

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

{

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

}

}

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

v e c t o r<cv : : Rect> boundRect ( 1 ) ;

v e c t o r<cv : : P o i n t 2 f>c e n t e r s ( 1 ) ;

fo r ( in t i = 0 ; i < 1 ; i++ )

{

cv : : approxPolyDP ( cv : : Mat ( m e r g e d c o n t o u r p o i n t s ) ,

c o n t o u r s p o l y [ i ] , 3 , true ) ;

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

c e n t e r s [ i ] , r a d i u s ) ;

}

// Draw C i r c l e onto r g b image

cv : : Mat draw ing = cv : : Mat : : z e r o s ( imgThr esho ld ed . s i z e ( ) , CV 8UC3

) ;

fo r ( in t i = 0 ; i< 1 ; i++ )

{

cv : : S c a l a r c o l o r = cv : : S c a l a r ( 0 , 0 , 2 2 5 ) ;

// cv : : S c a l a r c o l o r = cv : : S c a l a r ( rng . uniform ( 0 , 0) , rng .

uniform ( 0 , 0 ) , rng . uniform ( 5 0 , 2 2 5 ) ) ;

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

}

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

∗xpos = ( in t ) c e n t e r s [ 0 ] . x ;

∗ypos = ( in t ) c e n t e r s [ 0 ] . y ;

∗ r a d i = ( in t ) r a d i u s ;

}

//show t h e t h r e s h o l d e d image

imshow ( ” Th r e sh o ld ed Image ” , imgThr esho ld ed ) ;

}

## A.2 Object Tracking Method 2

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

r e t u r n s them

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

void rgbImage2 ( cv : : Mat im gO r i g i n a l , in t ∗ xpos , in t ∗ ypos , in t ∗ r a d i )

{

// ///// s t a t i c i n t count = 0 ;

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

cv : : P o i n t 2 f c e n t e r ;

f l o a t r a d i u s = 0 ;

c e n t e r . x = 0 ;

c e n t e r . y = 0 ;

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

// low was 100 i f t h a t needs t o change back

in t iLowH1 = 1 0 0 ;

in t iH ighH1 = 1 3 0 ;

in t iLowS1 = 1 0 0 ;

in t iH ighS1 = 2 5 5 ;

in t iLowV1 = 4 9 ;

in t iH ighV1 = 2 5 5 ;

in t iLowH2 = 0 ;

in t iH ighH2 = 5 0 ;

in t iLowS2 = 1 2 0 ;

in t iH ighS2 = 2 5 5 ;

in t iLowV2 = 1 0 0 ;

in t iH ighV2 = 2 5 5 ;

in t iLowH3 = 5 0 ;

in t iH ighH3 = 9 0 ;

in t iLowS3 = 5 0 ;

in t iH ighS3 = 2 5 5 ;

in t iLowV3 = 1 0 0 ;

in t iH ighV3 = 2 5 5 ;

cv : : Mat imgHSV ;

cv : : Mat imgL in es = cv : : Mat : : z e r o s ( im gO r i g i n a l . s i z e ( ) , CV 8UC3 ) ;

// Convert t h e cap tu r ed frame from BGR t o HSV

c v tC o l o r ( im gO r i g i n a l , imgHSV , cv : : COLOR BGR2HSV) ;

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

cv : : Mat imgThr esho ld ed = cv : : Mat : : z e r o s ( im gO r i g i n a l . s i z e ( ) , CV 8UC3

) ;

cv : : Mat imgThr esho ld ed1 = cv : : Mat : : z e r o s ( im gO r i g i n a l . s i z e ( ) ,

CV 8UC3 ) ;

cv : : Mat imgThr esho ld ed2 = cv : : Mat : : z e r o s ( im gO r i g i n a l . s i z e ( ) ,

CV 8UC3 ) ;

cv : : Mat imgThr esho ld ed3 = cv : : Mat : : z e r o s ( im gO r i g i n a l . s i z e ( ) ,

CV 8UC3 ) ;

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

CV 8UC3 ) ;

cv : : Mat b a l l ;

// Finds p i x e l v a l u e s in t h e s e t HSV range ( red ) .

inRange ( imgHSV , cv : : S c a l a r ( iLowH1 , iLowS1 , iLowV1 ) , cv : : S c a l a r (

iH ighH1 , iH ighS1 , iH ighV1 ) , imgThr esho ld ed1 ) ;

inRange ( imgHSV , cv : : S c a l a r ( iLowH2 , iLowS2 , iLowV2 ) , cv : : S c a l a r (

iH ighH2 , iH ighS2 , iH ighV2 ) , imgThr esho ld ed2 ) ;

inRange ( imgHSV , cv : : S c a l a r ( iLowH3 , iLowS3 , iLowV3 ) , cv : : S c a l a r (

iH ighH3 , iH ighS3 , iH ighV3 ) , imgThr esho ld ed3 ) ;

imgThr esho ld ed = imgThr esho ld ed1+imgThr esho ld ed2+imgThr esho ld ed3 ;

cv : : Moments oMoments = cv : : moments ( imgThr esho ld ed ) ;

im gO r i g i n a l . copyTo ( b a l l , imgThr esho ld ed ) ;

double dM01 = oMoments . m01 ;

double dM10 = oMoments . m10 ;

double dArea = oMoments . m00 ;

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

i f ( dArea > 1 0 0 0 0 )

{

// Prepare t h e image f o r f indCon tou rs

cv : : c v tC o l o r ( b a l l , b a l l , CV BGR2GRAY) ;

cv : : t h r e s h o l d ( b a l l , b a l l , 0 , 2 5 5 , CV THRESH BINARY) ;

//Find t h e con tou rs . Use t h e contourOutput Mat so t h e o r i g i n a l

image doesn ’ t g e t o v e r w r i t t e n

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

cv : : Mat contourOutput = b a l l . c l o n e ( ) ;

cv : : f i n dC o n t o u r s ( contourOutput , c o n t o u r s , CV RETR LIST ,

CV CHAIN APPROX NONE ) ;

cv : : f i n dC o n t o u r s ( contourOutput , c o n t o u r s , CV RETR EXTERNAL ,

CV CHAIN APPROX NONE ) ;

// approx imate con tou rs

s t d : : v e c t o r<cv : : Po in t> approx ;

cv : : Mat draw ing = cv : : Mat : : z e r o s ( imgThr esho ld ed . s i z e ( ) , CV 8UC3

) ;

cv : : S c a l a r c o l o r = cv : : S c a l a r ( 0 , 0 , 0 ) ;

cv : : S c a l a r c o l o r 2 = cv : : S c a l a r ( 0 , 0 , 0 ) ;

double maxCosine ;

in t typ e = 0 ;

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

fo r ( in t i = 0 ; i < c o n t o u r s . s i z e ( ) ; i++ )

{

approxPolyDP ( cv : : Mat ( c o n t o u r s [ i ] ) , approx , a r cL eng th ( cv : : Mat

( c o n t o u r s [ i ] ) , true ) ∗ 0 . 0 4 , true ) ;

typ e =0;

i f ( approx . s i z e ( ) == 4 && f a b s ( con tou rA r ea ( cv : : Mat ( approx ) ) )

> 100 && isContourConv ex ( cv : : Mat ( approx ) ) )

{

typ e = 1 ;

c ou t <<” There ’ s a s q u a r e h e r e ! \ n” ;

s t r i n g l a b e l = ” Squar e ” ;

fo r ( in t c = 0 ; c<approx . s i z e ( ) ; c++)

{

in t n e x t c = c +1;

i f ( n e x t c >=approx . s i z e ( ) )

{

n e x t c =0;

}

cv : : l i n e ( im gO r i g i n a l , approx [ c ] , approx [ n e x t c ] ,

c o l o r , 2 , 8 , 0 ) ;

}

in t c = 0 ;

cv : : putText ( im gO r i g i n a l , l a b e l , approx [ c ] , 1 , 1 . 0 ,

c o l o r 2 , 2 . 0 ) ;

}

i f ( approx . s i z e ( ) > 4 && f a b s ( con tou rA r ea ( cv : : Mat ( approx ) ) ) >

100 && isContourConv ex ( cv : : Mat ( approx ) ) )

{

typ e = 2 ;

c ou t <<” There ’ s a c i r c l e h e r e ! \ n” ;

s t r i n g l a b e l = ” C i r c l e ” ;

fo r ( in t c = 0 ; c<approx . s i z e ( ) ; c++)

{

in t n e x t c = c +1;

i f ( n e x t c >=approx . s i z e ( ) )

{

n e x t c =0;

}

cv : : l i n e ( im gO r i g i n a l , approx [ c ] , approx [ n e x t c ] ,

c o l o r , 2 , 8 , 0 ) ;

}

in t c = 0 ;

cv : : putText ( im gO r i g i n a l , l a b e l , approx [ c ] , 1 , 1 . 0 ,

c o l o r 2 , 2 . 0 ) ;

}

i f ( approx . s i z e ( ) < 4 && f a b s ( con tou rA r ea ( cv : : Mat ( approx ) ) ) >

100 && isContourConv ex ( cv : : Mat ( approx ) ) )

{

typ e = 3 ;

c ou t <<” There ’ s a t r i a n g l e h e r e ! \ n” ;

s t r i n g l a b e l = ” T r i a n g l e ” ;

fo r ( in t c = 0 ; c<approx . s i z e ( ) ; c++)

{

in t n e x t c = c +1;

i f ( n e x t c >=approx . s i z e ( ) )

{

n e x t c =0;

}

cv : : l i n e ( im gO r i g i n a l , approx [ c ] , approx [ n e x t c ] ,

c o l o r , 2 , 8 , 0 ) ;

}

in t c = 0 ;

cv : : putText ( im gO r i g i n a l , l a b e l , approx [ c ] , 1 , 1 . 0 ,

c o l o r 2 , 2 . 0 ) ;

}

}

i f ( cv : : waitKey ( 1 0 ) == 2 7 ) // wa i t f o r ’ es c ’ key p r e s s f o r 30

ms . I f ’ es c ’ key i s p r e s s e d , b r ea k l o o p

{

while ( 1 )

{

i f ( cv : : waitKey ( 3 0 ) == 2 7 )

break ;

}

}

}

imshow ( ” Th r e sh o ld ed Image ” , imgThr esho ld ed ) ;

}

# Appendix B

# Path Planning and

# Communication

## B.1 Main Code

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

#arm ov e r s e r i a l communication .

import numpy a s np

import arm

from PathP lann er import ∗

import commun icat ion

import s y s

import s u b p r o c e s s

import comms

from t a b u l a t e import t a b u l a t e

import t im e

#S e t arm t o i n i t i a l p o s i t i o n

d own l inkOb j e c t = commun icat ion . DownLink ( )

d own l inkOb j e c t . s endV a lu e s (90 ,−50 ,−50 ,−50)

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

us in g p i p e s t o s t a r t g e t da ta and end

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

# Get da ta o f a l l o b s t a c l e s from camera .

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

# O b s t i c l e 1 = [ 1 1 ,−4 ,−4 . 5 , 0 ]

# O b s t i c l e 2 = [ 5 , 1 1 , − 4 . 5 , 0 ]

# O b s t i c l e 3 = [ 0 , 0 , 0 , 0 ]

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

program w i l l end .

#D e f a u l t no o b j e c t s in workspace

inWorkspace = [ 0 , 0 , 0 ]

#Create arm o b j e c t

armObject = arm . Man ipu la to r ( )

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

i s . Gene ra t ing

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

O b s t i c l e 1 ,−90)

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

O b s t i c l e 2 ,−90)

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

O b s t i c l e 3 ,−90)

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

InWorkspace = [ ”Not In Workspace ” , ”Not In Workspace ” , ”Not In Workspace ” ]

fo r x in range ( 0 , 3 ) :

i f inWorkspace [ x ] :

InWorkspace [ x ] = ” In Workspace ”

FoundObject = [ ob1 , ob2 , ob3 ]

i f O b s t i c l e 1 [ 0 ] == −1:

FoundObject [ 0 ] = ”Not Found”

i f O b s t i c l e 2 [ 0 ] == −1:

FoundObject [ 1 ] = ”Not Found”

i f O b s t i c l e 3 [ 0 ] == −1:

FoundObject [ 2 ] = ”Not Found”

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

t a b l e = [ [ ” O b s t a c l e 1 ” , FoundObject [ 0 ] , InWorkspace [ 0 ] ] , [ ” O b s t a c l e 2 ” ,

FoundObject [ 1 ] , InWorkspace [ 1 ] ] , [ ” O b s t a c l e 3 ” , FoundObject [ 2 ] ,

InWorkspace [ 2 ] ] ]

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

them t h e y can q u i t t h e program .

pr int ”Which o b s t a c l e would you l i k e th e arm t o grab ? Ent er th e number . ”

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

program . ”

v a l i d = F a l s e

while v a l i d == F a l s e :

command = raw input ( )

i f command == ’ q ’ or command == ’Q ’ :

pr int ” E x i t i n g Program ”

e x i t ( )

e l i f command == ’ 1 ’ :

i f inWorkspace [ 0 ] :

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

us in g i n v e r s e k in em a t i c s

#p r i n t O b s t i c l e 1

g o a l = O b s t i c l e 1 A n g l e s

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

pr int ” t h e t a c ” , O b s t i c l e 1 [ 3 ]

# i f O b s t i c l e 1 [ 3 ]>4 0 :

# | goa lPa r t1 , InWorkspace , t h e t a c = armObject . c a l cu l a t eT h e t aC ( [ O b s t i c l e 1 [ 0 ] , O b s t i c l e 1 [ 1 ] , O b s t i c l e 1 [ 2 ]+ 3 , 0 ] )

# | p r i n t ”a”

i f abs ( g o a l [ 0 ]<3 0 ) :

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

e l i f g o a l [ 0 ] > 3 0 :

| g o a l P a r t 1 , InWorkspace , t h e t a c = armObject . c a l c u l a t eT h e t aC ( [ O b s t i c l e 1 [ 0 ] − 3 , O b s t i c l e 1 [ 1 ] − 3 , O b s t i c l e 1 [ 2 ] , 0 ] , 6 0 )
| pr int ” c ”

e l s e :

| g o a l P a r t 1 , InWorkspace , t h e t a c = armObject . c a l c u l a t eT h e t aC ( [ O b s t i c l e 1 [ 0 ] − 3 , O b s t i c l e 1 [ 1 ] + 3 , O b s t i c l e 1 [ 2 ] , 0 ] , 6 0 )
| pr int ”d”

i f InWorkspace == 0 :

| pr int ”W i l l not make i t ”

#p r i n t g o a l

pr int ”Grabb ing O b s t a c l e 1 . . . ”

v a l i d = True

e l s e :

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

workspa c e th e arm cannot go t h e r e . ”

e l i f command == ’ 2 ’ :

i f inWorkspace [ 1 ] :

# s e t Goal

#p r i n t O b s t i c l e 2

g o a l = O b s t i c l e 2 A n g l e s

pr int ” t h e t a c ” , O b s t i c l e 1 [ 3 ]

# i f O b s t i c l e 1 [ 3 ]>4 0 :

# | goa lPa r t1 , InWorkspace , t h e t a c = armObject . c a l cu l a t eT h e t aC ( [ O b s t i c l e 1 [ 0 ] , O b s t i c l e 1 [ 1 ] , O b s t i c l e 1 [ 2 ]+ 3 , 0 ] )

# | p r i n t ”a”

i f abs ( g o a l [ 0 ]<3 0 ) :

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

e l i f g o a l [ 0 ] > 3 0 :

| g o a l P a r t 1 , InWorkspace , t h e t a c = armObject . c a l c u l a t eT h e t aC ( [ O b s t i c l e 2 [ 0 ] − 3 , O b s t i c l e 2 [ 1 ] − 3 , O b s t i c l e 2 [ 2 ] , 0 ] , 6 0 )
| pr int ” c ”

e l s e :

| g o a l P a r t 1 , InWorkspace , t h e t a c = armObject . c a l c u l a t eT h e t aC ( [ O b s t i c l e 2 [ 0 ] − 3 , O b s t i c l e 2 [ 1 ] + 3 , O b s t i c l e 2 [ 2 ] , 0 ] , 6 0 )
| pr int ”d”

i f InWorkspace == 0 :

| pr int ”W i l l not make i t ”

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

#p r i n t g o a l

pr int ”Grabb ing O b s t a c l e 2 . . . ”

v a l i d = True

e l s e :

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

| workspa c e th e arm cannot go t h e r e . ”

e l i f command == ’ 3 ’ :

i f inWorkspace [ 2 ] :

# s e t Goal

#p r i n t O b s t i c l e 3

g o a l = O b s t i c l e 3 A n g l e s

pr int ” t h e t a c ” , O b s t i c l e 1 [ 3 ]

# i f O b s t i c l e 1 [ 3 ]>4 0 :

# | goa lPa r t1 , InWorkspace , t h e t a c = armObject . c a l cu l a t eT h e t aC ( [ O b s t i c l e 1 [ 0 ] , O b s t i c l e 1 [ 1 ] , O b s t i c l e 1 [ 2 ]+ 3 , 0 ] )

# | p r i n t ”a”

i f abs ( g o a l [ 0 ]<3 0 ) :

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

O b s t i c l e 3 [ 1 ] , O b s t i c l e 3 [ 2 ] , 0 ] , 6 0 )

pr int ”b”

e l i f g o a l [ 0 ] > 3 0 :

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

. c a l c u l a t eT h e t aC ( [ O b s t i c l e 3 [ 0 ] − 3 ,

O b s t i c l e 3 [ 1 ] − 3 , O b s t i c l e 3 [ 2 ] , 0 ] , 6 0 )

pr int ” c ”

e l s e :

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

. c a l c u l a t eT h e t aC ( [ O b s t i c l e 3 [ 0 ] − 3 ,

O b s t i c l e 3 [ 1 ] + 3 , O b s t i c l e 3 [ 2 ] , 0 ] , 6 0 )

pr int ”d”

i f InWorkspace == 0 :

pr int ”W i l l not make i t ”

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

#p r i n t g o a l

pr int ”Grabb ing O b s t a c l e 3 . . . ”

v a l i d = True

e l s e :

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

workspa c e th e arm cannot go t h e r e . ”

e l s e :

pr int ” S o r r y t h a t command was not r e c o g n i z e d . ”

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

t h e pa th t o t h e o b s t a c l e

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

c l o s e t o t h e o b s t a c l e .

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

t h e pa th moves t h e arm t o t h e

# 0 , 0 , 0 , 0 p o s i t i o n . ( s t r a i g h t ou t )

p l a n n e rO b j e c t = PathP lan ( )

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

s t a r t = [ 9 0 , − 2 0 , 3 0 , 0 ]

end = [ 0 ,−2 0 ,−2 0 , 2 0 ]

g o a l P a r t 2 = g o a l

# C lose Gr ipper

d own l inkOb j e c t . s endV a lu e s (−2000 ,−2000 ,−2000 ,−2000)

#send pa th a n g l e s

pr int g o a l P a r t 1

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

pr int path1

# T ra ve l f i r s t p a r t o f pa th

pr int ” T r a v e l i n g f i r s t p a r t o f path . ”

fo r it em in path1 :

d own l inkOb j e c t . s endV a lu e s ( it em [ 0 ] , it em [ 1 ] , it em [ 2 ] , it em [ 3 ] )

d own l inkOb j e c t . s endV a lu e s (−2000 ,−2000 ,−2000 ,−2000)

l e n g t h = len ( path1 ) −1

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

pr int path2

#T rav e l second p a r t o f pa th

pr int ” T r a v e l i n g s e c ond p a r t o f path . ”

fo r it em in path2 :

d own l inkOb j e c t . s endV a lu e s ( it em [ 0 ] , it em [ 1 ] , it em [ 2 ] , it em [ 3 ] )

pr int ” H o p e f u l l y g r abb in g o b j e c t . ”

# C lose Gr ipper

d own l inkOb j e c t . s endV a lu e s (−1000 ,−1000 ,−1000 ,−1000)

l e n g t h = len ( path2 ) −1

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

pr int path3

#pa th3 = pa th1

#pa th3 . r e v e r s e ( )

# Go back t o s t r a i g h t p o s i t i o n

pr int ”Moving arm t o d e f a u l t p o s i t i o n . ”

fo r it em in path3 :

d own l inkOb j e c t . s endV a lu e s ( it em [ 0 ] , it em [ 1 ] , it em [ 2 ] , it em [ 3 ] )

t im e . s l e e p ( 2 )

# Drop o b j e c t

pr int ” Dropp ing Ob j e ct . ”

# Open Gr ipper

d own l inkOb j e c t . s endV a lu e s (−2000 ,−2000 ,−2000 ,−2000)

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

t o t h e arm by s e r i a l

# communication . The arm c o n t r o l l e r than sends t h e co r r espond in g du ty

c y c l e t o t h e arm . Commands

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

X) , X f o r don ’ t ca re , c l o s e s

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

# # Open Gr ipper

# down l in kO b j e c t . sendVa lues (−2000,−2000,−2000,−2000)

# #T rav e l second p a r t o f pa th

# p r i n t ” T r a v e l in g second p a r t o f pa th . ”

# f o r item in pa th2 :

# | down l in kO b j e c t . sendVa lues ( item [ 0 ] , item [ 1 ] , item [ 2 ] , item [ 3 ] )

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

# # C lose Gr ipper

# down l in kO b j e c t . sendVa lues (−1000,−1000,−1000,−1000)

# # Go back t o s t r a i g h t p o s i t i o n

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

# f o r item in pa th3 :

# | down l in kO b j e c t . sendVa lues ( item [ 0 ] , item [ 1 ] , item [ 2 ] , item [ 3 ] )

# # Drop o b j e c t

# p r i n t ”Dropping O b j e c t . ”

# # Open Gr ipper

# down l in kO b j e c t . sendVa lues (−2000,−2000,−2000,−2000)

## B.2 Computer Communication

import s t r u c t

import numpy a s np

import s u b p r o c e s s

””” Th is i s f o r commun icat ing w ith th e computer t o g e t

data from th e camera . Use s o c k e t

”””

c l a s s G e tO b s t i c l e s :

def | i n i t | ( s e l f ) :

#D is tan c e between x a x i s o f camera and arm measured

| | a lon g z a x i s

s e l f . d i s t z = 2 9 . 8

#D is tan c e between Z a x i s o f camera and arm measured

| | a lon g x a x i s

s e l f . d i s t x = 6 . 7

#D is tan c e between y a x i s o f camera and arm measured

| | a lon g y a x i s

s e l f . d i s t y = 0 . 2

def g etData ( s e l f ) :

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

pr int ”About t o Run Program ”

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

1 0 0 , s t d o u t=s u b p r o c e s s . PIPE )

pr int ”Running Program ”

fo r x in range ( 0 , 1 0 ) :

p r o c . s t d o u t . r e a d l i n e ( )

x = y = z = 0 . 0 0 0 1

count = 0

fo r i in range ( 0 , 1 0 ) :

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

#p r i n t ”Python : ” , o b s t i c l e S t r i n g

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

x = x + f l o a t ( o b s t i c l e L i s t [ 0 ] )

y = y + f l o a t ( o b s t i c l e L i s t [ 1 ] )

z = z + f l o a t ( o b s t i c l e L i s t [ 2 ] )

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

count = count+1

#p r i n t x/ count , y/ count , z / count

x = x /10

y = y /10

z = z /10

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

pr int O b s t i c l e 1

p r o c . t e rm i n a t e ( )

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

s u b p r o c e s s . PIPE )

pr int ”Running Program ”

fo r x in range ( 0 , 1 0 ) :

p r o c . s t d o u t . r e a d l i n e ( )

x = y = z = count = 0

fo r i in range ( 0 , 1 0 ) :

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

#p r i n t ”Python : ” , o b s t i c l e S t r i n g

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

x = x + f l o a t ( o b s t i c l e L i s t [ 0 ] )

y = y + f l o a t ( o b s t i c l e L i s t [ 1 ] )

z = z + f l o a t ( o b s t i c l e L i s t [ 2 ] )

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

count = count+1

#p r i n t x/ count , y/ count , z / count

x = x /10

y = y /10

z = z /10

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

p r o c . t e rm i n a t e ( )

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

s u b p r o c e s s . PIPE )

pr int ”Running Program ”

fo r x in range ( 0 , 1 0 ) :

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

x = y = z = count = 0

fo r i in range ( 0 , 1 0 ) :

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

#p r i n t ”Python : ” , o b s t i c l e S t r i n g

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

x = x + f l o a t ( o b s t i c l e L i s t [ 0 ] )

y = y + f l o a t ( o b s t i c l e L i s t [ 1 ] )

z = z + f l o a t ( o b s t i c l e L i s t [ 2 ] )

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

count = count+1

#p r i n t x/ count , y/ count , z / count

x = x /10

y = y /10

z = z /10

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

O b s t i c l e 3 [ 2 ] = O b s t i c l e 3 [ 2 ]+ 3

p r o c . t e rm i n a t e ( )

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

c o o r d i n a t e s

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

i s 0 r e tu rn −1,−1,−1

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

O b s t i c l e = [−1 ,−1 ,−1 , 0 ]

i f ( r !=0) :

O b s t i c l e [ 0 ] = y + s e l f . d i s t x

O b s t i c l e [ 1 ] = −1∗x − s e l f . d i s t y

O b s t i c l e [ 2 ] = s e l f . d i s t z − z

return O b s t i c l e

## B.3 Micro Controller Communication

import s e r i a l

import s t r u c t

import numpy a s np

import t im e

c l a s s DownLink :

def | i n i t | ( s e l f ) :

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

s e l f . message=None

@stat i cm ethod

def i s V a l i d ( byt eArray , checkSum ) :

ch e ck=0 fo r ch in byt eArray [ 0 : 8 ] :

ch e ck=ch e ck+ord ( ch )

ch e ck = ch e ck&0xFF

i f ord ( checkSum )==ch e ck :

return True

e l s e :

return F a l s e

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

#s e l f . p o r t . w r i t e (DownLink . byteMap [ ”START TX” ] )

#p r i n t ”F” , v a lu e 1 , v a lu e 2 , v a lu e 3 , v a lu e 4

txM essag e=s t r u c t . pack ( ’<f ’ , v a l u e 1 )+s t r u c t . pack ( ’<f ’ ,

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

v a l u e 4 )

t im e . s l e e p ( 0 . 1 )

fo r b y t e s in txM essage :

s e l f . p o r t . w r i t e ( chr (ord ( b y t e s ) ) )

chk=DownLink . calcCheckSum ( txM essag e )

s e l f . p o r t . w r i t e ( chk )

@stat i cm ethod

def calcCheckSum ( byt eArray ) :

ch e ck=0

fo r b y t e s in byt eArray :

ch e ck=ch e ck+ord ( b y t e s )

return chr ( ch e ck&0xFF )

def r e l e a s e ( s e l f ) :

s e l f . p o r t . c l o s e ( )

## B.4 Path Planner

import numpy a s np

import arm

from heapq import heappush , heappop

import t im e

import math

def p r i n t t i m i n g ( fun c ) :

def wrapper (∗ a r g ) :

t 1 = t im e . t im e ( )

r e s = fun c (∗ a r g )

t 2 = t im e . t im e ( )

pr int ’%s took %0.3 f ms ’ % ( fun c . func name , ( t 2−t 1 ) ∗1 0 0 0 . 0 )

return r e s

return wrapper

c l a s s PathP lan :

def | i n i t | ( s e l f ) :

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

#s e l f . o b s t i c l e s ( ) = [ ]

s e l f . s t a r t P o s = np . z e r o s ( 4 )

s e l f . endPos = np . z e r o s ( 4 )

# C a l c u l a t e d Path

#s e l f . pa th

# Adjustment v a l u e s

s e l f . s t e p S i z e = 3

s e l f . o b s t i c l e C o s t = 100

s e l f . g o a lC o s t = 2

s e l f . toH er eCost = 1

s e l f . movements = [

( s e l f . s t e p S i z e , 0 , 0 , 0 ) ,

( 0 , s e l f . s t e p S i z e

, 0 , 0 ) , ( 0 , 0 , s e l f .

s t e p S i z e , 0 ) ,

( 0 , 0 , 0 , s e l f .

s t e p S i z e ) , (− s e l f .

s t e p S i z e , 0 , 0 , 0 ) ,

(0 ,− s e l f . s t e p S i z e , 0 , 0 ) ,

( 0 , 0 ,− s e l f . s t e p S i z e

, 0 ) , ( 0 , 0 , 0 , − s e l f .

s t e p S i z e ) | ]

#Some e x c l u d e d f o r

l e n g t h r easons

def d i s t a n c e 3 ( s e l f , p , q ) :

return np . s q r t ( ( p [ 0 ]− q [ 0 ] ) ∗∗2 + ( p [ 1 ]− q [ 1 ] ) ∗∗2 + ( p [ 2 ]− q

[ 2 ] ) ∗∗2)

def d i s t a n c e 4 ( s e l f , p , q ) :

return np . s q r t ( ( p [ 0 ]− q [ 0 ] ) ∗∗2 + ( p [ 1 ]− q [ 1 ] ) ∗∗2 + ( p [ 2 ]− q

[ 2 ] ) ∗∗2 + ( p [ 3 ]− q [ 3 ] ) ∗∗2)

def s qu a r e 1 ( s e l f , p ) :

s = p [ 0 , 0 ] ∗ ∗ 2 + p [ 1 , 0 ] ∗ ∗ 2 + p [ 2 , 0 ] ∗ ∗ 2

return s

def s qu a r e 2 ( s e l f , p ) :

s = p [ 0 ] ∗ ∗ 2 + p [ 1 ] ∗ ∗ 2 + p [ 2 ] ∗ ∗ 2

return s

def mult ( s e l f , p , q ) :

m = [ p [ 0 , 0 ] ∗ q [ 0 , 0 ] , p [ 1 , 0 ] ∗ q [ 1 , 0 ] , p [ 2 , 0 ] ∗ q [ 2 , 0 ] ]

return m

@ p r i n t t im i n g

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

# C a l c u l a t e pa th from i n p u t s

armObject = arm . Man ipu la to r ( )

f r o n t = [ ( 0 . 0 0 1 , 0 . 0 0 1 , s t a r t , None ) ]

# In t h e b e g inn in g , no c e l l has been v i s i t e d .

v i s i t e d = [ ]

x = 0

# A lso , we use a d i c t i o n a r y t o remember where we came

from .

came from = [ ]

i f pathPart == 1 :

atGoa l = 3

e l s e :

atGoa l = 0 . 5

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

f o rw a rdK in em a t i c s ( g o a l )

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

pr int ” P lann in g Path ”

while f r o n t :

# Get sm a l l e s t item and remove from f r o n t .

e l em en t = heappop ( f r o n t )

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

# CHANGE 01 e : use t h e f o l l o w i n g l i n e as shown .

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

# Now i t has been v i s i t e d . Mark w i th c o s t .

fo r it em in v i s i t e d :

i f it em == pos :

continue #r e tu rn t o top o f w h i l e

l o o p

v i s i t e d . append ( pos )

#p r i n t pos

# A lso remember t h a t we came from p r e v i o u s when

we marked pos .

came from . append ( p r e v i o u s )

x=x+1

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

armObject . f o rw a rdK in em a t i c s ( pos )

# Check i f t h e g o a l has been reached .

i f ( s e l f . d i s t a n c e 3 ( xyzPos , Goa lxyzPos )<=atGoa l ) :

#i f ( s e l f . d i s t a n c e 4 ( pos , g o a l )<=12) :

break # F in ish ed !

# Check a l l n e i g h b o r s .

fo r d1 , d2 , d3 , d4 in s e l f . movements :

# Determine new p o s i t i o n and check

bounds .

n ew th e t a 1 = pos [ 0 ] + d1

i f n ew th e t a 1> 90 | n ew th e t a 1 <−90:
| continue

n ew th e t a 2 = pos [ 1 ] + d2

i f n ew th e t a 2>120 | n ew th e t a 2 <−50:
| continue

n ew th e t a 3 = pos [ 2 ] + d3

i f n ew th e t a 3>120 | n ew th e t a 3 <−55:
| continue

n ew th e t a 4 = pos [ 3 ] + d4

i f n ew th e t a 4>120 | n ew th e t a 4 <−55:
| continue

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

and no o b s t a c l e .

new pos = ( n ew th e t a 1 , n ew th e t a 2 ,

n ew th e t a 3 , n ew th e t a 4 )

fo r it em in v i s i t e d :

i f it em == new pos :

continue #r e tu rn t o top

o f w h i l e l o o p

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

new pos , pos )

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

new pos , g o a l )

# add c o s t t o a vo id o b s t i c l e s

o b s t i c l e c o s t = 0

f l o o r c o s t = 0

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

armObject . f o rw a rdK in em a t i c s (

new pos )

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

fo r it em in o b s t i c l e s :

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

| +1/( s e l f . d i s t a n c e 3 ( it em ,
| xyzPos ) )

heappush ( f r o n t , ( f l o o r c o s t+ s e l f .

toH e r eCos t ∗ c o s t t o n e w p o s+ s e l f .

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

c o s t t o n e w p o s , new pos , pos ) )

# R e cons t ru c t pa th , s t a r t i n g from g o a l .

path = [ ]

i f ( s e l f . d i s t a n c e 3 ( xyzPos , Goa lxyzPos )<=atGoa l ) : # I f we

reached t h e g o a l , unwind backwards .

#i f ( s e l f . d i s t a n c e 4 ( pos , g o a l )<=12) :

while pos :

fo r it em in v i s i t e d :

i f it em == pos :

break #r e tu rn t o top o f

w h i l e l o o p

ind e x = v i s i t e d . ind e x ( it em )

pos = came from [ ind e x ]

i f pos :

path . append ( pos )

path . r e v e r s e ( ) # Reverse so t h a t pa th i s from

s t a r t t o g o a l .

return path

## B.5 Kinematics

import numpy a s np

import math

c l a s s Man ipu la to r :

def | i n i t | ( s e l f ) :

# End E f f e c t o r P o s i t i on

# I s p o s i t i o n in x , y , z , t h e t a c

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

| | p o s i t i o n

s e l f . e n d E f f e c t o r P o s = [ 1 2 . 9 5 1 , 0 , 0 , 0 ]

# Gr ipper V a r i a b l e

# z e ro = c l o s e d one = open

s e l f . G r ipp e r = 0

# DH Tab le pa rameters o f man ipu la to r

# Ang le P o s i t i on

# Ang les o f t h e 4 j o i n t s

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

0 , 0 , 0 , 0

# Ang les a re in d e g r e e s

s e l f . a n g l e s = [ 0 , 0 , 0 , 0 ]

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

# DH pa rame te rs , a l l l i n k s f o r t h e man ipu la to r ar a

l e n g t h s

# and a re i n i t a l i z e d he re

s e l f . l e n g t h s = [ 3 . 7 0 4 , 2 . 6 2 6 , 2 . 9 9 5 , 5 . 0 2 6 ]

# a lpha v a l u e s

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

# This v a r i a b l e i s in rad ians

s e l f . a l p h a s = [ − 1 . 5 7 , 0 , 0 , 0 ]

# d v a l u e s

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

# f o r t h i s man ipu la to r t h e s e a re a l l z e ro

s e l f . d v a l u e s = [ 0 , 0 , 0 , 0 ]

def f o rw a rdK in em a t i c s ( s e l f , a n g l e s ) :

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

man ipua la to r

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

#c on v e r t t o rad ians

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

#Get t r an s f o rm a t i on ma t r ix

H1 = s e l f . DHtable ( a n g l e s , 0 )

H2 = s e l f . DHtable ( a n g l e s , 1 )

H3 = s e l f . DHtable ( a n g l e s , 2 )

H4 = s e l f . DHtable ( a n g l e s , 3 )

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

#I s s e t as a ma t r ix b e caus e i t needs t o be a 4 x1 ,

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

#must a c c e s s i t i s a ma t r ix not an a r ray

d = [ [ 0 ] , [ 0 ] , [ 0 ] , [ 1 ] ]

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

T j o i n t 1 = H1∗d

T j o i n t 2 = H1∗H2∗d

T j o i n t 3 = H1∗H2∗H3∗d

T j o i n t 4 = H1∗H2∗H3∗H4

#P o s i t i on o f end e f f e c t o r

E n d E f f e c t o r = T j o i n t 4 ∗d

T j o i n t 4 = T j o i n t 4 ∗d

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

math . p i

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

# in v e rs eK in co r r espond in g mat lab f u n c t i o n

#C a l c u l a t e t h e t a v a l u e s

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

s e l f . l e n g t h s [ 0 ]

z c = e n d E f f e c t o r [ 2 ]

z c = −1∗z c

t h e t a c=e n d E f f e c t o r [ 3 ] ∗ math . p i /180

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

an imag inary number w i l l be r e tu rn ed

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

# in f a c t b r ea k . :O

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

l e n g t h s [ 2 ] ) )

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

i f abs ( c o s t h e t a 3 ) > 1 :

i n v e r s e P o s s i b l e = 0

a n g l e s = [ 0 , 0 , 0 , 0 ]

e l s e :

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

i n v e r s e P o s s i b l e = 1

t h e t a 3 = math . a c o s ( c o s t h e t a 3 )

t h e t a 2 = math . atan ( ( z c−s e l f . l e n g t h s [ 3 ] ∗ math . s i n (

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

) ) ) −math . atan ( ( s e l f . l e n g t h s [ 2 ] ∗ math . s i n (

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

math . c o s ( t h e t a 3 ) ) )

t h e t a 4 = t h e t a c−t h e t a 2−t h e t a 3

#sa v e a n g l e s t o a r ray

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

#c on v e r t a n g l e s t o d e g r e e s

a n g l e s = [ x ∗ 180/math . p i fo r x in a n g l e s ]

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

def DHtable ( s e l f , a n g l e s , i ) :

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

a n g l e s

# DH3 co r r espond in g mat lab f u n c t i o n

T znm1 = np . matr ix ( [ [ 1 , | 0 , 0 , 0 ] , | [ 0 , 1 , 0 , 0 ] , | [ 0 , 0 , 1 , s e l f
. d v a l u e s [ i ] ] , | [ 0 , 0 , 0 , 1 ] ] )

R znm1 = np . matr ix ( [ [ math . c o s ( a n g l e s [ i ] ) ,−math . s i n (

a n g l e s [ i ] ) , 0 , 0 ] , | [ math . s i n ( a n g l e s [ i ] ) , math . c o s (
a n g l e s [ i ] ) , 0 , 0 ] , | [ 0 , 0 , 1 , 0 ] , | [ 0 , 0 , 0 , 1 ] ] )
T xn = np . matr ix ( [ [ 1 , | 0 , 0 , s e l f . l e n g t h s [ i ] ] , | [ 0 , 1 , 0 , 0 ] ,
[ 0 , 0 , 1 , 0 ] , | [ 0 , 0 , 0 , 1 ] ] )
R xn = np . matr ix ( [ [ 1 , | 0 , 0 , 0 ] , | [ 0 , math . c o s ( s e l f . a l p h a s [
i ] ) ,−math . s i n ( s e l f . a l p h a s [ i ] ) , 0 ] , | [ 0 , math . s i n ( s e l f .
a l p h a s [ i ] ) , math . c o s ( s e l f . a l p h a s [ i ] ) , 0 ] , | [ 0 , 0 , 0 , 1 ] ] )

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

T = T znm1∗R znm1∗T xn∗R xn

return T

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

cannot go t o p o s i t i o n r e tu rn 0

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

pa thP lann ing f i l e

canReach = F a l s e

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

fo r t h e t a c in xrange ( minAngle , 9 0 ) :

e n d E f f e c t o r [ 3 ] = t h e t a c

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

e n d E f f e c t o r )

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

s o l u t i o n s have been

#found

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

Ang l es ) :

#t h e t a c makes p o s s i b l e

pr int t h e t a c

canReach = True

break

return Ang l es , canReach , t h e t a c

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

0 i f not

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

p a r t o f pa thP lann ing f i l e

# i s InAn g l eC on s t r a in t s = 1

return ( ( a n g l e s [0 ]<=90) & ( a n g l e s [0]>=−90) & ( a n g l e s

[1]>=−50) & ( a n g l e s [1 ]<=120) & ( a n g l e s [2]>=−55) & (

a n g l e s [2 ]<=120) & ( a n g l e s [3]>=−110) & ( a n g l e s

[3 ]<=90) )

# Appendix C

# Arm Code

## C.1 Main Code

#inc lude ” arm main . h”

#inc lude ”arm . h”

// L i b ra r y f o r s t r i n g h an d l in g

#inc lude <s t r i n g . h>

// L i b ra r y f o r s p r i n t f

#inc lude <s t d i o . h>

// L i b ra r y f o r a t o f

#inc lude <s t d l i b . h>

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

#inc lude ”BAPlib / bap ma in . h”

// L i b ra r y f o r GPIO

#inc lude ”BAPlib / b a p 1 1 g p i o . h”

// L i b ra r y f o r us in g t h e BAP UART

#inc lude ”BAPlib / b a p 1 1 u a r t . h”

// L i b ra r y f o r BAP PWM

#inc lude ”BAPlib /bap1 1 pwm . h”

// L i b ra r y t o read adc and b a t t e r y

extern s t ruc t s mympu mympu ;

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

#inc lude ” u t i l s / cmd l in e . h”

#inc lude ”BAPlib / b a p 1 1 t e s t e r . h”

#de f ine SCI DELIMr ’ \ r ’

#de f ine SCI DELIMn ’ \n ’

#de f ine TB BUFF LEN 100

char u a r tT xBu f f e r 1 [ TB BUFF LEN ] ;

f l o a t t h e t a 1 ;

f l o a t t h e t a 2 ;

f l o a t t h e t a 3 ;

f l o a t t h e t a 4 ;

in t Data Ready =0;

in t pathLength =0;

union Data

{

unsigned char b y t e s [ 1 6 ] ;

f l o a t r e s u l t [ 4 ] ;

} ;

void arm main ( )

{

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

// Welcome message

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

BAPSendMessage ( u a r tT xBu f f e r 1 ) ;

// i n i t a l i z e arm

sendDuty ( 0 , 0 , 0 , 0 ) ;

setGPIO (PB7) ;

op enGr ipp er ( ) ;

while ( 1 )

{

i f ( Data Ready )

{

i f ( t h e t a 1==−1000)

{

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

” ) ;

BAPSendMessage ( u a r tT xBu f f e r 1 ) ;

c l o s e G r i p p e r ( ) ;

}

e l s e i f ( t h e t a 1==−2000)

{

s p r i n t f ( u a r tT xBu f f e r 1 , ” G r ipp e r opened . \ n

” ) ;

BAPSendMessage ( u a r tT xBu f f e r 1 ) ;

op enGr ipp er ( ) ;

}

e l s e

{

s p r i n t f ( u a r tT xBu f f e r 1 , ” 1 : %f 2 : %f 3 : %f

4 : %f \n” , t h e t a 1 , t h e t a 2 , t h e t a 3 ,

t h e t a 4 ) ;

BAPSendMessage ( u a r tT xBu f f e r 1 ) ;

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

;

}

Data Ready =0;

}

}

}

void c amd a t a c a l lB a c k ( unsigned char c )

{

s t a t i c in t ind e x = 0 ;

s t a t i c union Data data ;

// s p r i n t f ( ua r tT xBu f f e r1 , ” a ”) ;

//BAPSendMessage ( ua r tT xBu f f e r1 ) ;

i f ( ind e x < 1 6 )

{

data . b y t e s [ ind e x ]= c ;

++ind e x ;

}

e l s e

{

unsigned char chkSum = 0 ;

chkSum=c ;

i f ( i s V a l i d ( data . b y t e s , chkSum ) )

{

t h e t a 1 = data . r e s u l t [ 0 ] ;

t h e t a 2 = data . r e s u l t [ 1 ] ;

t h e t a 3 = data . r e s u l t [ 2 ] ;

t h e t a 4 = data . r e s u l t [ 3 ] ;

Data Ready = 1 ;

}

ind e x =0;

}

}

in t i s V a l i d ( unsigned char ∗dataArray , unsigned char checkSum )

{

in t i ;

in t Sum=0;

fo r ( i =0; i <16; i++)

{

Sum+=dataArray [ i ] ;

}

i f ( (Sum&0xFF )==checkSum )

{

return 1 ;

}

return 0 ;

}

## C.2 Arm Functions

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

//Goes from −90 t o 90 d e g r e e s .

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

{

f l o a t pu lseW idth ;

i f ( a n g l e<=0)

{

pu lseW idth = 1500 − a n g l e ∗9 . 4 4 4 4 4 4 4 4 4 4 4 4 4 4 ;

// du ty = 0.077− an g l e ∗0 .00043889 ;

}

e l s e

{

pu lseW idth = 1500 − a n g l e ∗8 . 8 8 8 8 8 8 8 8 8 8 8 9 ;

// du ty = 0.077− an g l e ∗.00048333 ;

}

return pu lseW idth ;

}

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

{

f l o a t pu lseW idth ;

i f ( a n g l e<=0)

{

pu lseW idth = 2000 − a n g l e ∗1 1 . 1 6 6 6 6 6 7 ;

// du ty = 0.0995− an g l e ∗0 .000446 ;

}

e l s e

{

pu lseW idth = 2000 − a n g l e ∗ 8 . 8 ;

// du ty = 0.0995− an g l e ∗.0004667 ;

}

return pu lseW idth ;

}

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

{

f l o a t pu lseW idth ;

i f ( a n g l e<=0)

{

pu lseW idth = 1900 − a n g l e ∗ 9 . 5 ;

// du ty = 0.0945− an g l e ∗0 .000455 ;

}

e l s e

{

pu lseW idth = 1900 − a n g l e ∗9 . 2 7 2 7 2 7 2 7 2 7 3 ;

// du ty = 0.0945− an g l e ∗. 0 0 0 4 33 ;

}

return pu lseW idth ;

}

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

{

f l o a t pu lseW idth ;

i f ( a n g l e<=0)

{

pu lseW idth = 1650 + a n g l e ∗9 . 8 8 8 8 8 8 8 8 8 8 9 ;

// du ty = 0.0815+ an g l e ∗0 .00051818 ;

}

e l s e

{

pu lseW idth = 1650 + a n g l e ∗1 0 . 8 1 8 1 8 1 8 1 8 1 8 1 8 2 ;

// du ty = 0.0815+ an g l e ∗. 0 0 0 5 ;

}

return pu lseW idth ;

}

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

void c l o s e G r i p p e r ( )

{

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

p u l s e w id th

f l o a t pu l s eW id thM i c r o s e c ond s = 1 7 0 0 ;

changePu lseW idth ( 7 , pu l s eW id thM i c r o s e c ond s ) ;

}

//open Gr ipper

void op enGr ipp er ( )

{

// Value found t o work b e s t f o r open i s 200ms p u l s e w id th

f l o a t pu l s eW id thM i c r o s e c ond s = 2 6 0 0 ;

changePu lseW idth ( 7 , pu l s eW id thM i c r o s e c ond s ) ;

}

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

s e t t h e g i v en

// a n g l e s .

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

{

f l o a t pu lseW idth1 , pu ls eW idth2 , pu ls eW idth3 , pu ls eW idth4 ;

pu lseW idth1 = g e tPu l s eW id th J o in t 1 ( a n g l e 1 ) ;

pu lseW idth2 = g e tPu l s eW id th J o in t 2 ( a n g l e 2 ) ;

pu lseW idth3 = g e tPu l s eW id th J o in t 3 ( a n g l e 3 ) ;

pu lseW idth4 = g e tPu l s eW id th J o in t 4 ( a n g l e 4 ) ;

changePu lseW idth ( 2 , pu lseW idth1 ) ;

changePu lseW idth ( 3 , pu lseW idth2 ) ;

changePu lseW idth ( 4 , pu lseW idth3 ) ;

changePu lseW idth ( 5 , pu lseW idth4 ) ;

}

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

void shutOffArm ( )

{

sendDuty ( 0 , 9 0 , 0 , 0 ) ;

p r evT i ck = T i c k s ;

while ( ( T i ck s−p r evT i ck ) <25) ;

// ///////////////// g i o S e t B i t (gioPORTA , 0 , 0) ;

c learGPIO (PD1) ;

}

//Turns on arm and pu t s in s t r a i g t ou t p o s i t i o n .

void turnOnArm ( )

{

// ////////////////////// g i o S e t B i t (gioPORTA , 0 , 1 ) ;

setGPIO (PD1) ;

sendDuty ( 0 , 0 , 0 , 0 ) ;

}

# Bibliography

[1] Open CV documentaion. Retrieved from http://docs.opencv.org/
[2] PCL | documentaion. | Retrieved | from

http://pointclouds.org/documentation/

[3] DepthsenseSDK | documentaion. | Retrieved | from

http://www.softkinetic.com/Support

[4] Kristoffer Aasland, (2008). Optimal 3D Path Planning for a 9 DOF

Robot Manipulator with Collision Avoidance Retrieved from http://www.

diva-portal.org/smash/get/diva2:347626/FULLTEXT01.pdf

[5] Mohamed Abdellatif, (2008). Effect of Color Pre-Processing on Color-

Based Object Detection Retrieved from http://www.researchgate.net/

profile/Mohamed_Abdellatif3/publication/248390823_Effect_of_

Color_Pre-Processing_on_Color-Based_Object_Detection/links/

02e7e51de87e9efc3f000000.pdf

[6] Khaled Alhamzi, Mohammed Elmogy, Sherif Barakat, (2014). 3D Object
Recognition | Based | on | Image

Features: A Survey Retrieved from http://www.academia.edu/7188944/

3D_Object_Recognition_Based_on_Image_Features_A_Survey

[7] G. J. Garca, P. Gil, D. Llcer, F. Torres, (2012). Guidance of Robot Arms

using Depth Data from RGB-D Camera Retrieved from http://rua.ua.

es/dspace/bitstream/10045/30156/1/ICINCO_2013_154_CR.pdf
