aherkelman/Bachelors-Thesis-/control.JPG

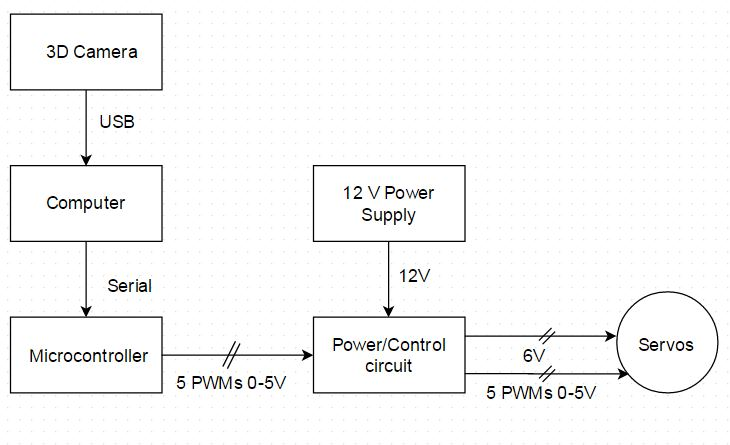
control.JPG
