aherkelman/Bachelors-Thesis-/GMM.JPG

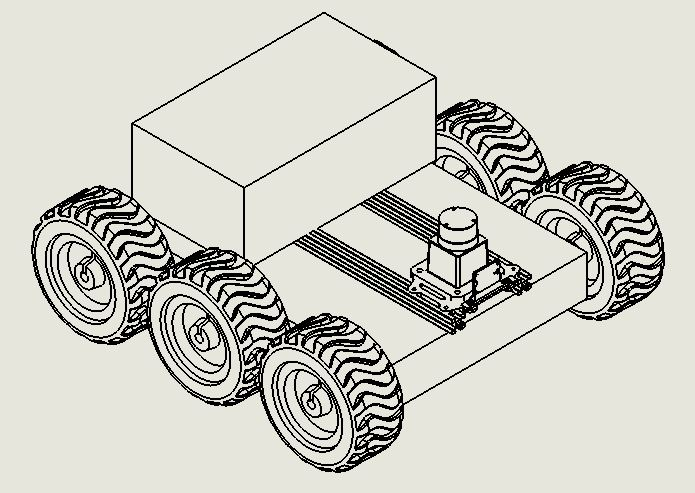
GMM.JPG
