aherkelman/Bachelors-Thesis-/gmmBehind.JPG

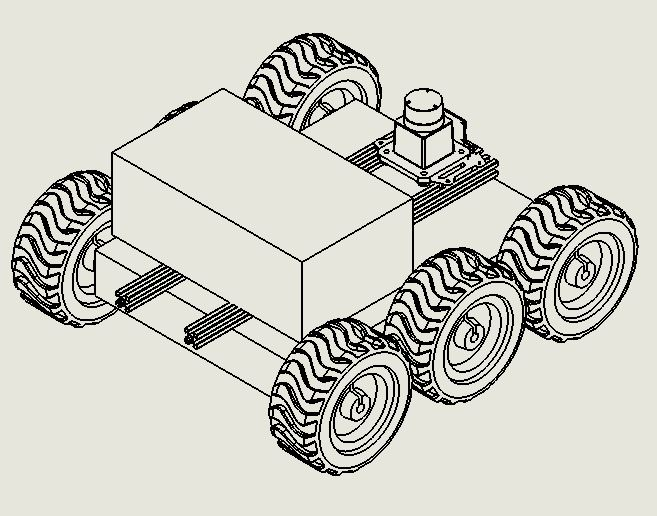
gmmBehind.JPG
