aherkelman/Bachelors-Thesis-/GMMside.JPG

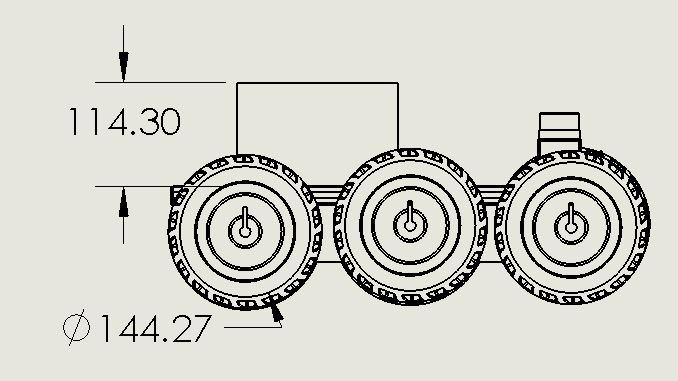
GMMside.JPG
