aherkelman/Bachelors-Thesis-/GMMtop.JPG

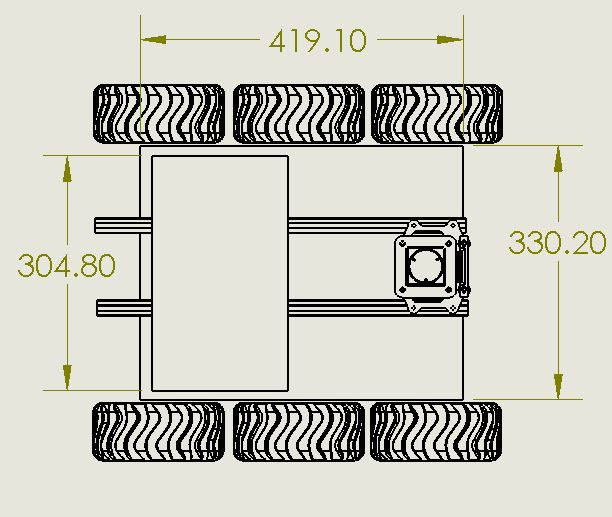
GMMtop.JPG
