aherkelman/Bachelors-Thesis-/Images/hardware/armsolidworks.JPG

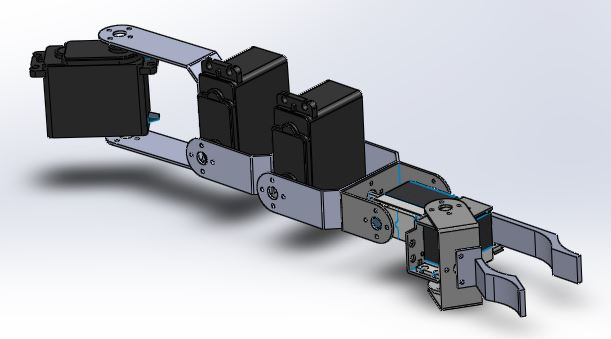
Images/hardware/armsolidworks.JPG
