aherkelman/Bachelors-Thesis-/Images/hardware/connectors.JPG

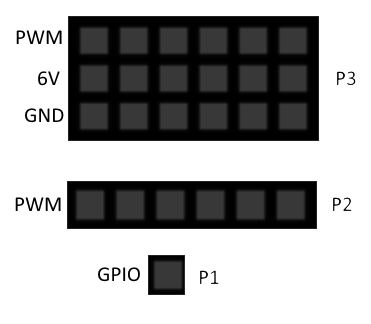
Images/hardware/connectors.JPG
