aherkelman/Bachelors-Thesis-/Images/imageprocessing/armholder.JPG

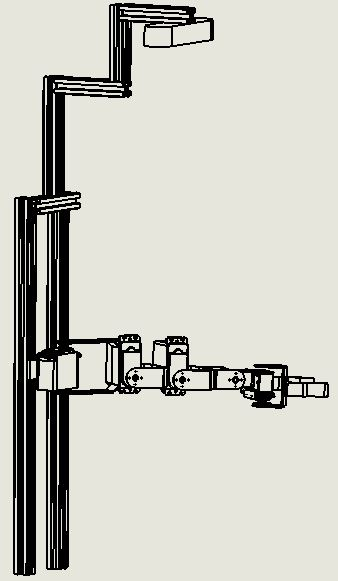
Images/imageprocessing/armholder.JPG
