aherkelman/Bachelors-Thesis-/Images/imageprocessing/shapes.png

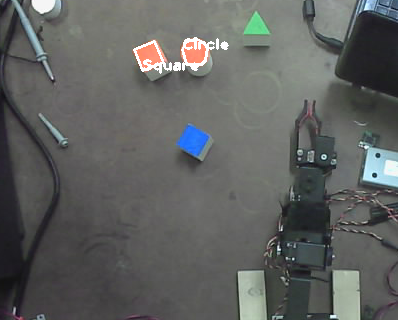
Images/imageprocessing/shapes.png
