aherkelman/Bachelors-Thesis-/Images/IMP/path.png

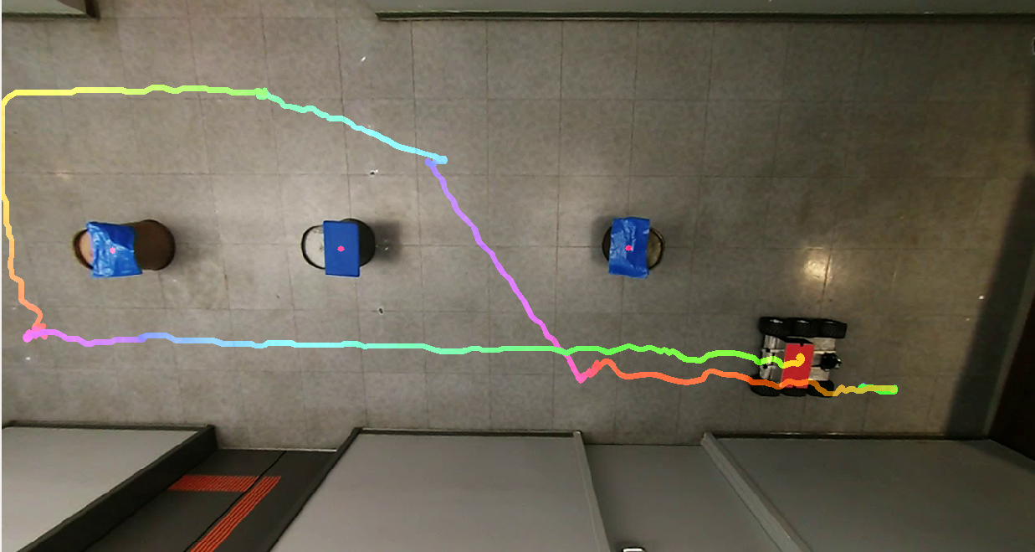
Images/IMP/path.png
