aherkelman/Bachelors-Thesis-/Images/kinematics/manipulator.png

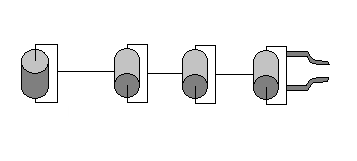
Images/kinematics/manipulator.png
