aherkelman/Bachelors-Thesis-/Images/kinematics/manipulatoraxis.png

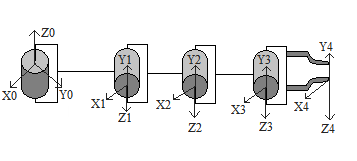
Images/kinematics/manipulatoraxis.png
