aherkelman/Bachelors-Thesis-/Images/kinematics/workspace.JPG

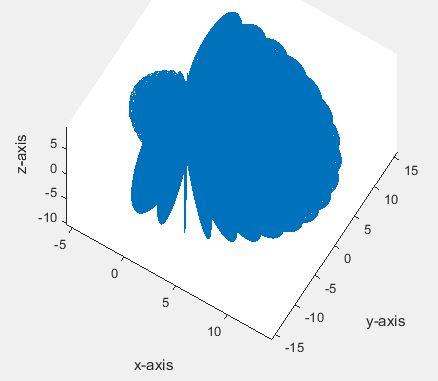
Images/kinematics/workspace.JPG
