aherkelman/Bachelors-Thesis-/Images/kinematics/xyaxis.png

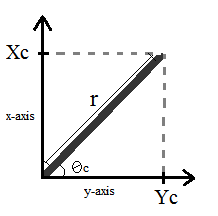
Images/kinematics/xyaxis.png
