aherkelman/Bachelors-Thesis-/arm.SLDASM

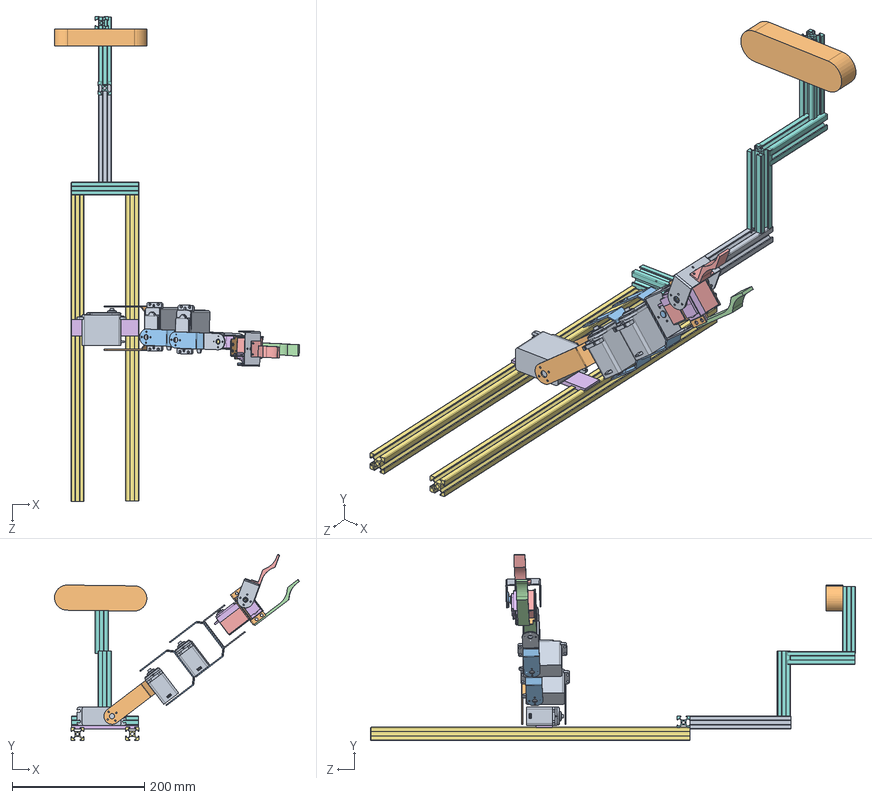
[picture p41: CAD file, 2015-06-15]
arm.SLDASM
370.4 x 282.0 x 733.6 mm
Servo HS755 x 3
asb-203
asb-202 x 2
bottom cover x 2
servo Case x 2
servo cover x 2
spline output x 2
long screw x 8
asb-09 x 2
asb-04
HMSH-01
gripperthumb
finger
tracks x 2
tracks4in x 4
tracks6in
camera
