aherkelman/Bachelors-Thesis-/camera.SLDPRT

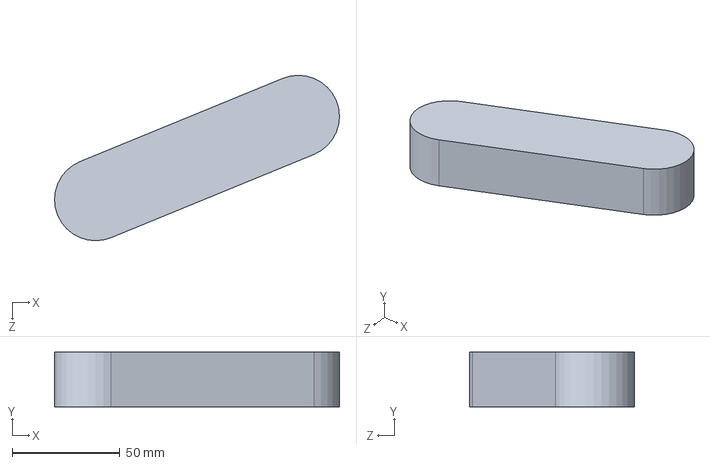
[picture p42: CAD file, 2015-06-15]
camera.SLDPRT
132.1 x 25.4 x 76.7 mm
