aherkelman/Bachelors-Thesis-/tracks6in.SLDPRT

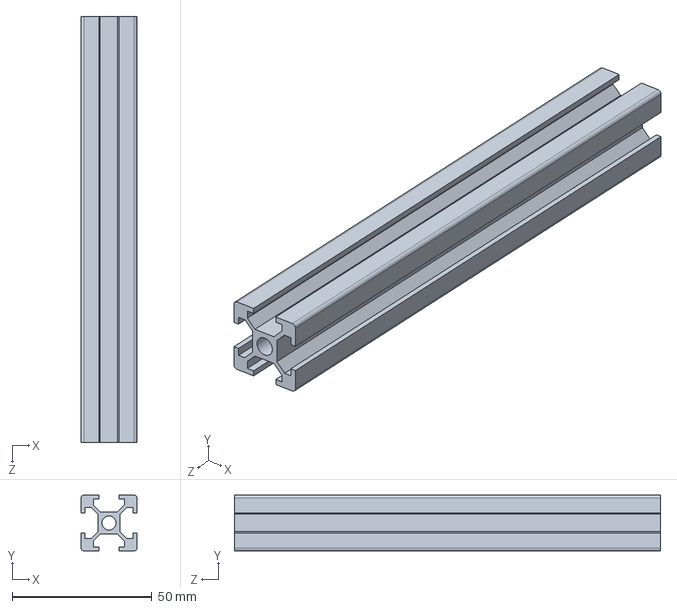
[picture p43: CAD file, 2015-06-15]
tracks6in.SLDPRT
20.0 x 20.0 x 152.4 mm
