aherkelman/Bachelors-Thesis-/Part1.SLDPRT

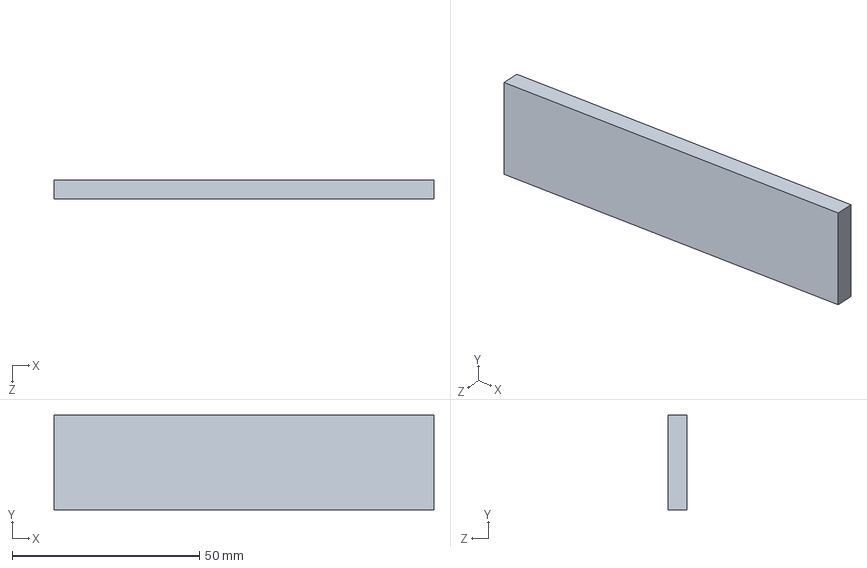
[picture p44: CAD file, 2015-06-15]
Part1.SLDPRT
101.6 x 25.4 x 5.00 mm
