aherkelman/Bachelors-Thesis-/tracks4in.SLDPRT

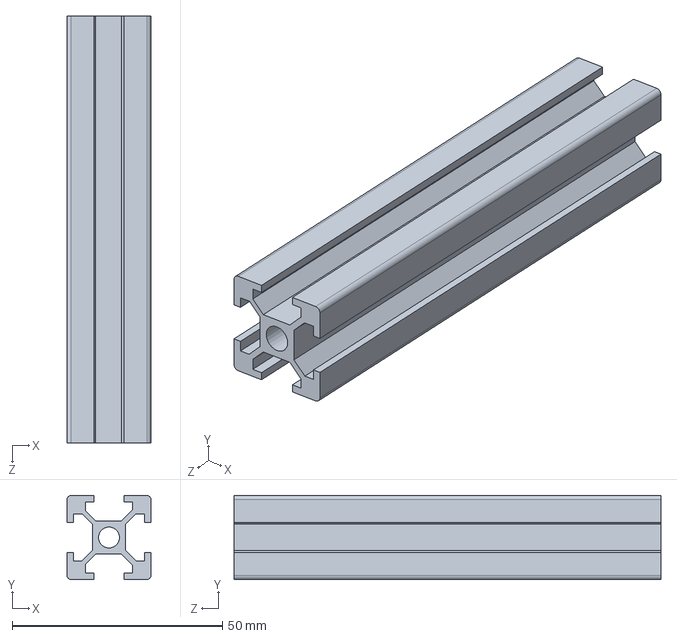
[picture p45: CAD file, 2015-06-15]
tracks4in.SLDPRT
20.0 x 20.0 x 101.6 mm
