aherkelman/Bachelors-Thesis-/Images/results/2.JPG

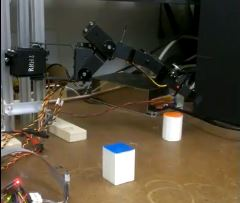
Images/results/2.JPG
