aherkelman/Bachelors-Thesis-/Images/results/3.JPG

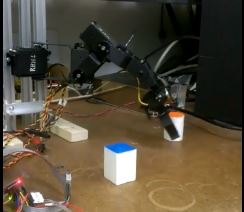
Images/results/3.JPG
