aherkelman/Bachelors-Thesis-/Images/results/4.JPG

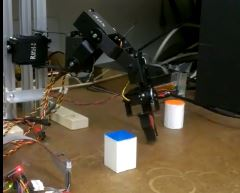
Images/results/4.JPG
