aherkelman/Bachelors-Thesis-/Images/results/5.JPG

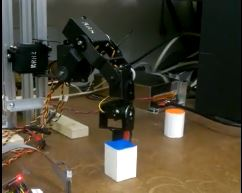
Images/results/5.JPG
