aherkelman/Bachelors-Thesis-/Images/results/6.JPG

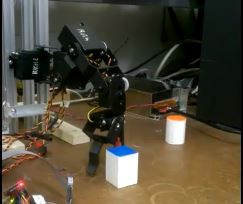
Images/results/6.JPG
