aherkelman/Bachelors-Thesis-/Images/results/7.JPG

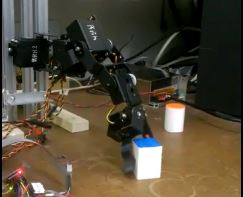
Images/results/7.JPG
