aherkelman/Bachelors-Thesis-/Images/results/8.JPG

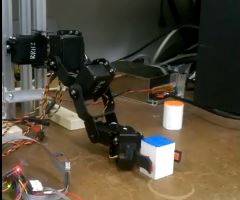
Images/results/8.JPG
