aherkelman/Bachelors-Thesis-/Images/results/9.JPG

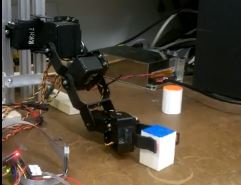
Images/results/9.JPG
