aherkelman/Bachelors-Thesis-/Images/results/11.JPG

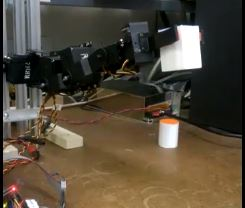
Images/results/11.JPG
